kavehs87/nuc-fan-controller/fan-switch-booster/docs/pcb-render-bottom.png

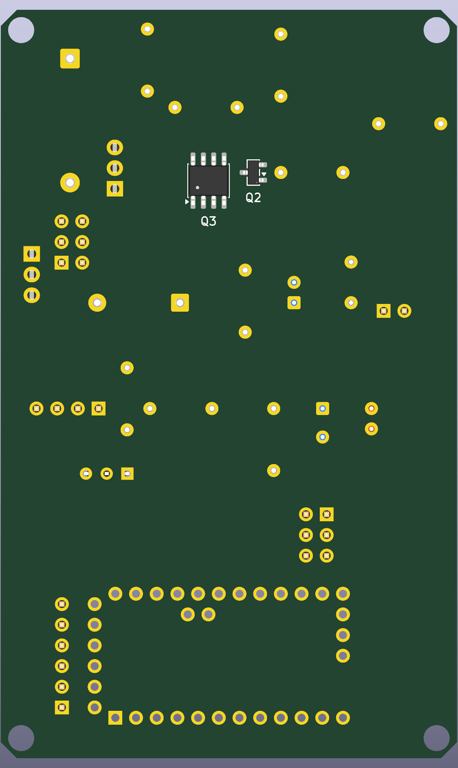
fan-switch-booster/docs/pcb-render-bottom.png
