kavehs87/nuc-fan-controller/fan-switch-booster/docs/pcb-render-smd-copper.png

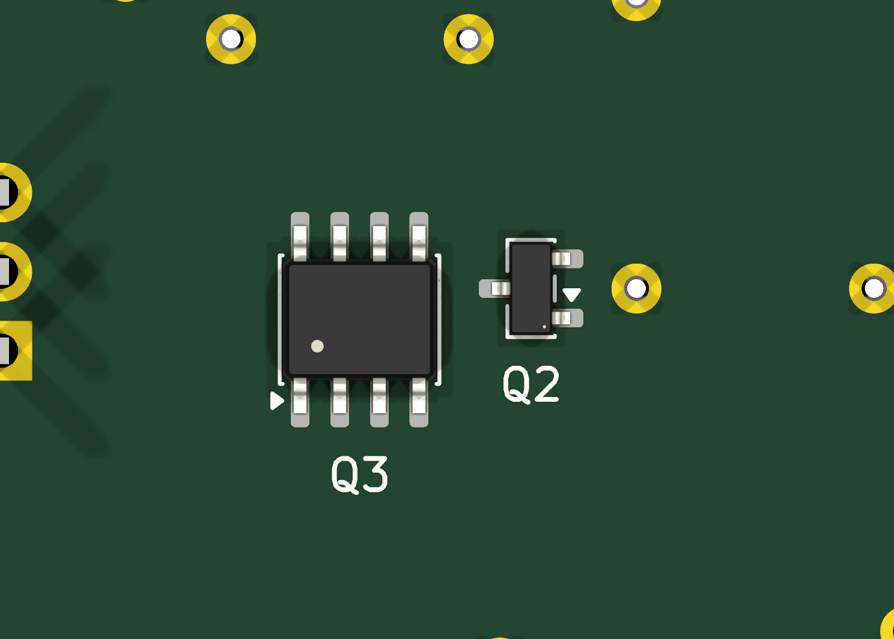
fan-switch-booster/docs/pcb-render-smd-copper.png
