kavehs87/nuc-fan-controller/fan-switch-booster/docs/pcb-render-top.png

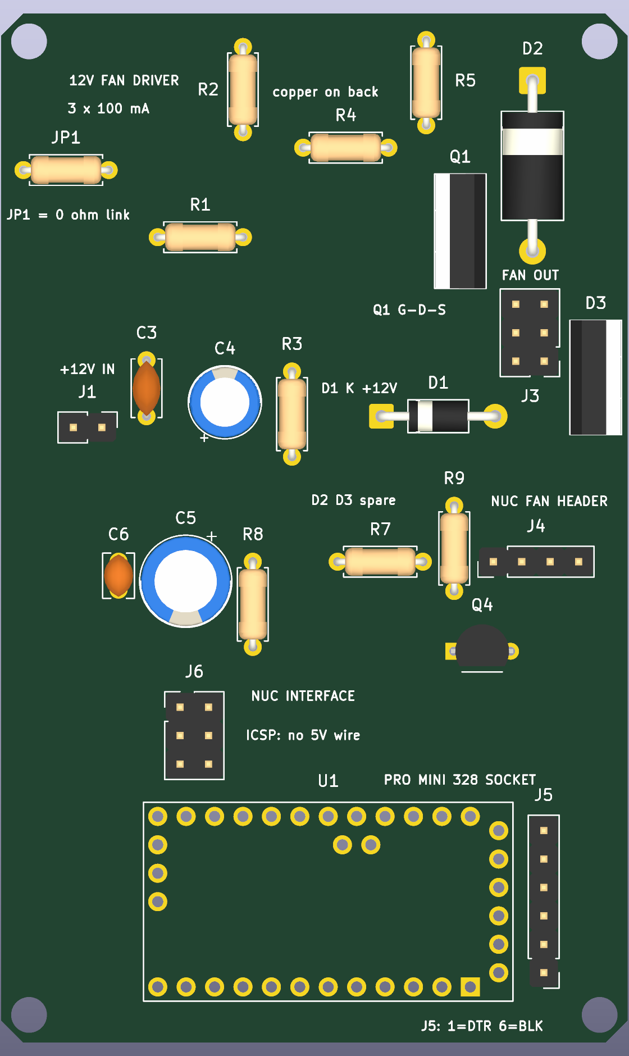
fan-switch-booster/docs/pcb-render-top.png
