kavehs87/nuc-fan-controller/BUILD.md

# nuc-fan-controller — Mode B (19 V → 12 V fan supply, follows the NUC's PWM, simulates the tach)

> **This build sheet is for a retired board.** The board was never built: the perfboard fan‑switch booster in
> `fan-switch-booster/` is the reference, and the KiCad project, exports and board generator this file
> describes were removed from the tree in October 2026 — they are complete at the tag
> **`nuc-fan-controller-full-2026-10-23`**. What is still live here is the *measurement* half of this file:
> identifying the four header wires with a meter, the divider and top‑of‑swing procedure, the BC547 pin‑order
> check, the log pairing and offsets, and the calibration order. Those apply to any build, including the
> perfboard's.

An 88.9 × 76.2 mm single‑copper‑layer board — small enough to etch at home — that sits between a 6th‑gen
NUC's processor‑fan header and a 12 V fan in a custom enclosure. It does four things:

1. brings **12 V** to the fan from an **off-board XL4016E1 step-down module** that plugs into
   J6 (19 V in on pin 3, its two returns on pins 1–2, 12 V out on pin 4);
2. makes **3.3 V** from that 12 V for a 3.3 V / 8 MHz Arduino Pro Mini;
3. reads the **PWM duty the ITE is asking for** and drives the fan at that duty through a
   12 V low-side switch;
4. reports a **tach rate** that matches what that duty would really produce, so the ITE's
   closed loop closes instead of hunting.

The fan is an ordinary **two-pin 12 V fan**: no PWM input, no tach wire. All the speed
control happens on this board, and all the tach the NUC sees is generated here.

The old Mode A board (fixed‑RPM tach simulator only) was archived in `archive/modeA-2026-10-19/`; that
directory went with the retirement and is at the tag. Nothing on it changed.

---

## Files

| File | What it is |
|---|---|
| ~~`nuc-fan-controller.kicad_*`~~, ~~`exports/`~~, ~~`fab/`~~ | **not in the tree any more.** The project, its schematic/board/etch prints, its BOM and its Gerbers are at the tag `nuc-fan-controller-full-2026-10-23` |
| `firmware/nuc-tach-modeB/nuc-tach-modeB.ino` | the sketch, and where the measured ITE constants live |
| `firmware/nuc-tach-modeA/` | the previous fixed‑RPM sketch, kept for reference |
| `firmware/probe-uno/`, `probe-gain/`, `probe-loop/`, `probe-temp/`, `probe-divider/` | the breadboard sketches the measurements below were made with |
| `bench/analyze-ladder.py`, `bench/analyze-temp.py`, `bench/analyze-cold.py`, `bench/analyze-heat.py` | the analysers, run against `bench/data/` — they take log paths and an offset, not defaults |
| `bench/plot-curve.py` | draws `docs/bench/06-ite-fan-response.svg`, the two‑panel graph of the ITE's demand, from the same logs |
| `bench/data/` | the raw logs behind every number in this file: 1 Hz traces of the divider reading, and of the NUC's temperatures — which pair is which run is the table below |
| `docs/bench/` | the bench photos and the fan-response graph the README shows |
| ~~`logs/`~~ | **not in the tree any more.** The board's ERC and DRC reports, `pour.png`, and the whole generator — `build1l.py`, `getfp.py`, `fp-templates.inc`, `setrules.py`, `pourcheck.py`, `verify.py`, `genwires.py`, `applywires.py`, `export.sh` — are at the same tag. The board is *generated*, not drawn by hand: its parts, bars, holes and router live in `build1l.py`, and `verify.py` was the check KiCad cannot do — whether the pour is one island that reaches every GND pad, and whether every net is one piece of copper matching the schematic pin by pin |

**Which log is which run.** The Uno's logs print one line per second and carry no timestamps; the NUC's
logs are epoch-stamped with `PHASE` markers, so a pair is aligned by the offset the capture scripts were
started with (the Uno opens the port, which resets the board, a known number of seconds before the NUC
starts logging). `analyze-heat.py` takes that offset as an argument.

| Uno log | NUC log | what the run was |
|---|---|---|
| `loop.log` | — | the RPM ladder 800 / 2000 / 4500 with the fan drive pinned at 90 %; no temperature capture |
| `temp.log` | `stress.log` | claim frozen at 1500 RPM, package 55 → 83 → 53 °C, bench fans switched by hand |
| `cold.log` | `coldtemp.log` | claim frozen, bench fans at maximum, package 32–36 °C for twelve minutes |
| `stress2.log` | `stress2-temps.log` | claim frozen, fans at maximum, `stress-ng --cpu 4` for 300 s: package 34 → 73 °C, board only to 55.5 °C |
| `warm.log` | `warm-temps.log` | claim frozen, bench fans off, NUC blower at minimum, board warmed by hand, then `stress-ng --cpu 4` for 240 s: board to 68.5 °C, package pinned at 88 °C |
| `hold.log` | `hold-temps.log` | claim frozen, fans off, a 300 s four-core ramp then **1200 s at a two-core load** so the board sits at 68.5–69 °C for sixteen flat minutes — the time-at-temperature test. Its `baseline` loop was left out of the capture script, so the log starts mid-ramp at 41 °C |
| `nucmon-idle.log` | — | the NUC's own sensors at idle, for the record |

*The next three paragraphs are the retired board's CAD record, as of 2026‑10‑20. They are kept because the
findings in them are transferable; the commands cannot be re‑run from this tree.*

**ERC: 0 violations.** **DRC: 0 errors** after `kicad-cli pcb drc nuc-fan-controller.kicad_pcb
--refill-zones --save-board` (2026-10-20), with 26 `lib_footprint_mismatch` warnings and 1
`unconnected_items` warning, both explained under *Board*: every footprint on this board is a modified
copy of a library footprint, and the one thing joining the two halves of `FAN_PWM` is the 0 Ω bridge R11,
which a board-only ratsnest cannot know is a part.

`logs/verify.py`, which does not care what KiCad thinks, reports: every net is one piece of copper
(`FAN_PWM`'s two pieces joined by R11), the pour is one island of 5 009 mm² and every GND pad lies inside
it, no copper of two nets touches, and the board matches the schematic netlist pin by pin on all 30
components.  The schematic's own no-connect is J2 pin 4, the NUC header's fan-supply wire, which this
board deliberately does not connect.

The schematic is drawn with **wires, not net labels**: every pin reaches its neighbour
through a drawn wire, and the rails are `power:+12V / +3V3 / GND` symbols sitting on
the pins. Every signal net carries a name tag (`19V`, `FAN_SW`, `BASE`,
`FAN_GATE`, `GATE`, `TACH_BASE`, `NUC_TACH`, `NUC_PWM`, `PWM_DIV`, `PWM_IN`, `TACH_OUT`, `FAN_PWM`) so
the print, the netlist, the board and the Gerber netlist all use the same readable names.
Delete a tag and KiCad renames that net to `Net-(…)` everywhere downstream.

---

## The circuit, in five blocks

*The circuit as the retired board drew it, in the designators that board used. The built version of the same
idea — the gate booster, its nets and its measured behaviour — is `fan-switch-booster/README.md`.*

```
A. 19 V in, the module, 12 V out            B. 12 V → 3.3 V, for the Pro Mini only
   J1 19V IN ─ 19V ─ J6 pin 3                 +12V ─ U3 AMS1117-3.3 ─ +3V3
   J1 pin 2 ─ GND ─ J6 pin 2                   C7 10µ + C8 100n on 3V3
   J6 pin 1 ─ GND                              C9 100p sits on NUC_TACH, TP1 is its test point
   J6 pin 4 ─ +12V ─ C3 470 µ/25V ─ C4 100n ─ GND
   J6 is the module's socket: 19 V in on 3, its two returns on 1 and 2,
   12 V out on 4. The XL4016E1 itself is not on this board — it is bolted to
   the enclosure and connected to J6 with a four-wire harness.
   There is no 5 V rail anywhere on this board: a drive's 5 V must never come from here.

C. NUC interface (signals only)             D. 12 V fan speed drive
   J2  NUC fan header                        FAN_PWM (from D11) ─ R6 1k ─ BASE ─ R7 10k ─ GND
     1 GND                                          BASE ─ Q2 BC547B base;  Q2 emitter → GND
     2 NUC_TACH  ─ C9 100p ─ GND                    Q2 collector ─ FAN_GATE ─ R8 1k ─ +12V
     3 NUC_PWM   ─ R3 4.7k                          FAN_GATE ─ R9 120 Ω ─ GATE ─ Q3 gate
                                                   GATE ─ R10 10k ─ GND
     4  (no connect: the header's fan supply)       Q3 IRFZ44N:  gate GATE, drain FAN_SW, source GND
   NUC_TACH ─ Q1 BC547B collector                   FAN_SW ─ D2 1N5819 ─ +12V   (freewheel)
   Q1 base ─ TACH_BASE ─ R2 1k ─ D9 (OC1A)          FAN_SW ─ J7 pin 2 ─ J3 pin 2 ─ J4 pin 2
   Q1 emitter ─ GND                                 FAN_SW ─ C12 100n ─ GND   (snubber at the fan end)
   NUC_PWM ─ R3 4.7k ─ R4 2.2k ─ PWM_IN ─ C10 1µ    +12V ─ J7 pin 1 ─ J3 pin 1 ─ J4 pin 1
                        PWM_IN ─ R5 10k ─ GND
                        PWM_IN ─ C11 100n ─ GND     J7 / J3 / J4 are the three 2-pin 12 V fan connectors
                        PWM_IN ─ A0
E. Pro Mini header J5: 1 GND, 2 TACH_OUT (D9), 3 FAN_PWM (D11), 4 PWM_IN (A0), 5 +3V3
```

**Q1 is open-collector.** It only ever pulls `NUC_TACH` low; the pull-up that makes the
high side is inside the NUC. That is the whole point — a push-pull drive from a 3.3 V pin
would hold the tach line ~1.7 V under whatever rail the ITE pulls it to, and would push
that current into the AVR. Q1 cannot do either, and its Vceo (45 V) is indifferent to
which rail the ITE chose.

**Q2 exists because IRFZ44N is not a logic-level FET.** Its Vgs(th) is 2–4 V, so 3.3 V from
a pin is not enough to turn it on. Q2 is driven by the AVR, and R8 1 kΩ pulls Q3's gate to
+12 V whenever Q2 is off. Q2 inverts once; the sketch inverts once more, so the fan ends up
with the duty the ITE asked for. R7 (10 kΩ base pull-down) and R10 (10 kΩ gate pull-down)
hold the two transistors off during the ~1.2 s the Pro Mini's bootloader leaves its pins
floating, which otherwise leaves Q3's gate at the mercy of a 12 V pull-up through 1 kΩ.

**D2 is not optional.** A fan is a motor winding. Every time Q3 turns off, that winding
kicks `FAN_SW` above the 12 V rail; D2 (1N5819, 40 V, 3 A) clamps it back into the rail it
came from. Without it the edge rings into the 12 V rail, and no buck — this one switches at
about 180 kHz and regulates through an output capacitor, not through the fan's commutation —
is fast enough to clean that up.

**C12 100 n sits on FAN_SW at the fan end.** `FAN_SW` is the node the commutating fan windings and D2's
recovery both live on, so it is the noisiest place on the board. 100 n there is a small snubber: against the
~120 Ω a 12 V fan presents at full speed it is a 12 µs time constant, which is short enough not to blunt the
32 µs pulses of the 31.25 kHz drive and long enough to take the edge off the switching spike.

**C9 is 100 pF, not 100 nF.** At 40 Hz with a 1–10 kΩ pull-up, 100 nF gives a 0.1–1 ms time
constant against a 12.5 ms half-period — harmless — but 100 nF on a tach line invites
ringing and crosstalk from a 31.25 kHz fan drive sitting 30 mm away. 100 pF kills RF and
leaves the edges alone.

---

## BOM, and where the parts came from

*This is the retired board's BOM. The reference build — the perfboard — has its own parts sheet now:
`docs/parts-collection.md` §1, and the schematic‑side list is `fan-switch-booster/README.md`,
*Parts — all from my cabinets*.*

All through-hole except one SMD part — U3, a TO-252 — which is hand-solderable without a stencil.  All
already in the cabinet.  `docs/parts-collection.md` and its `.html` twin carry the same list as a
walk-the-cabinet checklist, with quantities including spares and the measurements each part has to give up
before its footprint can be fixed.

| Ref | Value | Footprint | Cabinet |
|---|---|---|---|
| C3 | 470 µF 25 V | `Capacitor_THT:CP_Radial_D8.0mm_P3.50mm` — the board puts its pads 5.08 mm apart; **the cabinet's 8×20 can has to give up its lead pitch** | L1 C1 (6) |
| C4, C8, C11, C12 | 100 nF | `Capacitor_THT:C_Disc_D6.0mm_W2.5mm_P5.00mm` — the library draws 5.00 mm pitch, the board uses 5.08 so the pads sit on the grid | L1 C9 (30) |
| C7 | 10 µF | `Capacitor_THT:CP_Radial_D6.3mm_P2.50mm` | L1 D3 (4), spare pool L1 C1 (19) |
| C9 | 100 pF | `Capacitor_THT:C_Disc_D3.8mm_W2.6mm_P2.50mm` | L1 C9 (8) |
| C10 | 1 µF | `Capacitor_THT:CP_Radial_D6.3mm_P2.50mm` | L1 E7 (8) |
| U3 | AMS1117-3.3 | `Package_TO_SOT_SMD:TO-252-3_TabPin2` — the cabinet's TO-252 part; **the SOT-223 in the same drawer will not fit these pads** | L1 B1 (19) |
| R3 | 4.7 kΩ | `Resistor_THT:R_Axial_DIN0204_L3.6mm_D1.6mm_P5.08mm_Horizontal` | R1 B2 |
| R4 | 2.2 kΩ | same | R1 A2 |
| R5, R7, R10 | 10 kΩ | same | R1 B2 |
| R2, R6, R8 | 1 kΩ | same | R1 A2 |
| R9 | 120 Ω | same | R1 B1 |
| **R11** | **0 Ω — board only, not in the schematic** | same DIN0204 footprint | the bridge that carries `FAN_PWM` over the divider row: a 0 Ω, a scraped-off component lead, or a staple of bare wire |
| Q1, Q2 | BC547B | `Package_TO_SOT_THT:TO-92_Inline_Wide` | R1 D3 (20) — **meter them first, see "Which way round a BC547 goes"** |
| Q3 | IRFZ44N | `Package_TO_SOT_THT:TO-220-3_Vertical` | R1 B4 (12) |
| D2 | 1N5819 | `Diode_THT:D_DO-41_SOD81_P10.16mm_Horizontal` — kept at the library's 10.16 mm pitch, so the silk outline matches the part | L1 E1 (30) |
| J1, J3, J4, J7 | 19 V IN · FAN 1 · FAN 2 · FAN 3 | `Connector_PinHeader_2.54mm:PinHeader_1x02_P2.54mm_Vertical` — **male** strips | L1 E9 (7) — snap from a 5-pin strip |
| J6 | BUCK MODULE — 1, 2 GND · 3 19 V · 4 12 V | `Connector_PinHeader_2.54mm:PinHeader_1x04_P2.54mm_Vertical` — male | L1 E9 — snap a 5-pin strip to 4 |
| J5 | Pro Mini | `Connector_PinHeader_2.54mm:PinHeader_1x05_P2.54mm_Vertical` — male | L1 E9 (7) — a 5-pin strip, as it comes |
| J2 | NUC fan header | `Connector:FanPinHeader_1x04_P2.54mm_Vertical` — the shrouded 4-pin header the NUC's fan plug mates with.  The board's copy has its retention-peg hole left undrilled: the peg lands on the `NUC_PWM` lane | L1 E9 — snap a 5-pin strip to 4, shrouded if the cabinet has one |
| TP1 | TACH test point | `TestPoint:TestPoint_Pad_D1.5mm` | no part: a bare pad |
| MK1–4 | M3 mounting holes | `MountingHole:MountingHole_3.2mm_M3` | no part: a 3.2 mm hole |
| — | Arduino Pro Mini **3.3 V / 8 MHz** | 5-pin header into J5 | L1 C5 (1) |
| — | **XL4016E1 step-down module**, 19 V in → 12 V out | off-board, bolted to the enclosure, four wires into J6 | L1 A10 (1) |

The BOM csv KiCad writes has 30 lines, not 35: R11, the four mounting holes, the module and the Pro Mini
are not schematic components, so they are correctly absent from it.  They are on this table because the
table is what gets built.

**Why the buck is a module now.** This board used to build its converter out of parts — LM2596T-ADJ,
a 100 µH 6 A toroid, a 1N5822 catch diode, and a 10 kΩ trimmer in the feedback divider with R1 1 kΩ
under it. That design is in git at `10bc262` and every part of it is still in the cabinet (LM2596T and
LM2576HVT in L1 E7, 100 µH toroids in L1 A7, 1N5822 in L1 E1, 10 kΩ multi-turn trimmers in R1 A3). What changed is
that the cabinet also holds a finished step-down module, and at 12 V / 0.3 A a finished module is the
better answer: the **XL4016E1 module in L1 A10** carries the XL4016E1 controller and a 20S100 Schottky
catch diode, each on its own heatsink, with its input and output electrolytics and two multi-turn trimmers
— CV for the output voltage, CC for a constant-current limit — so RV1, R1, C1, C2, U1, D1 and L1 all left
the board and one 4-pin header took their place.

The numbers that make it safe come from the module's own catalogue record, cross-checked against the bare
XL4016E1 data sheet (LCSC **C55881**, TO-220-5):

* **5–40 V in (≤32 V for continuous use), 1.2–36 V out, 8 A continuous and 12 A with extra cooling, about
  180 kHz, 95–96 % efficient, ~50 mV output ripple.** 19 V in and 12 V out sit in the middle of all of it,
  and the output must be below the input — which is this design, and the reason a buck-boost is not needed.
* **Hugely derated at this load.** Three fans at full speed are 0.3 A out of an 8 A part (measured, see
  *Power budget*), so its dual heatsinks sit barely warm and its short-circuit, overload and
  over-temperature protections never have to do anything.
  Its record also lists input reverse-polarity protection, which is a courtesy this board does not have:
  J1 pin 1 is +19 V and C3 is a 25 V part.
* **It stays in continuous conduction where the fans actually work**, which is what makes a big buck
  unpleasant at a small current: inductor ripple is `Vout × (1 − Vout/Vin) / (L·f)` ≈ 12 × 0.368 /
  (150 µH × 180 kHz) ≈ **0.16 A** peak-to-peak, so the boundary is about 0.08 A and 0.3 A clears it by
  almost 4×. Near the ITE's idle demand the rail current drops below it — see *Power budget* for why C3
  and `FAN_DUTY_MIN` are the answer to that.
* **Its ripple does not reach the analogue side.** 50 mV at 180 kHz on the 12 V rail goes through two
  AMS1117 LDOs before it can touch 5 V or 3.3 V, and the `PWM_IN` divider's time constant is milliseconds
  against a 5.6 µs switching period — attenuation of about 5 000×, so those 50 mV arrive at A0 as 10 µV.
  The divider's own ripple budget, from the ITE's 23 kHz signal, is 2.2 counts (see *Known limits*); the
  buck is nowhere near it.

The module is about **61 × 41 × 27 mm** with its heatsinks, which is the whole reason it is off the board:
that is a third of the board's area and 27 mm of height, and its heatsinks want air moved across them
rather than a lid sitting on top. The other candidate in the cabinet was the **LTC3780 buck-boost module**
(L1 A5: 5–32 V in, 1–30 V out, 10 A, 80 W, 78 × 47 mm, replaceable fuse); it is the bigger board and it
buys nothing here, because this supply's input is always above its output. The DC modules that are *not*
candidates are worth naming so the search does not have to be repeated: the "Switching Power Supply Module
6th Gen 12 V 450 mA" (L1 B7) takes 85–265 V AC, and the IP2721 PD trigger (L1 A5) and the 100 W USB-PD
output module (L1 E5) need a USB-C source that negotiates 12 V.

**Why 120 Ω for R9** rather than the usual 10–47 Ω gate resistor: there is no 100 Ω or 47 Ω
value in the cabinet in the size needed. It is not the resistor that limits turn-on, though —
with Q2 off the gate is fed through R8 1 kΩ + R9 120 Ω = 1.12 k, so turn-on current is
12 / 1.12k = **10.7 mA**, and R10 10 kΩ pulls the gate down to 12 × 10 / 11.12 = **10.7 V**,
above the 10 V at which IRFZ44N's Rds(on) is specified. R9's real job is the fast half: on
turn-off the gate dumps through 120 Ω alone into Q2's saturated collector (≈ 89 mA), so the
falling edge is under 1 µs. Turn-on is the slow half — 1.7 µs to charge Ciss 1.5 nF, then
≈ 7.5 µs of Miller plateau at 6.1 mA out of the 32 µs period, which costs about 0.3 W in the
FET at a 0.2 A fan and leaves the fan's true duty roughly 7 µs short of the commanded one.
Both are why the RPM mapping is calibrated at the bench rather than derived from arithmetic.
Dropping R8 to 470 Ω (two 1 kΩ in parallel) would cut the plateau to about 3 µs if the FET
ever runs warm; it raises Q2's collector current to 21 mA, which 2.6 mA of base drive still
saturates.

**Two SMD parts.** The SOT-223 regulators are the only ones. They are hand-solderable with
a fine tip and a little flux (drag the tip across the three pads with solder on it), and
their tab pad is the VOUT pad on this footprint, which is the one that wants the most heat.
If you would rather not solder SMD: an AMS1117 in TO-263 will not drop into this footprint,
so keep the SOT-223.

---

## Power budget, and what the board actually carries

*Retired board's budget — the numbers are still the right ones for any 12 V build of this idea.*

| Rail | What hangs off it | Worst case |
|---|---|---|
| 19 V in | J1 → J6 → the module's input | 0.4 A at 12 V / 0.3 A out, ~90 % efficiency |
| +12 V | J6 pin 4, C3/C4, U3, R8, D2, J7, J3, J4 | **0.3 A, measured** — three 12 V fans at full speed, 300 mA together |
| +3V3 | Pro Mini, C7/C8, the divider's load side | ~25 mA |
| FAN_SW | Q3's drain, J7/J3/J4 pin 2, D2, C12 | 0.3 A pulsed |

**The fan load is measured, not assumed: three 12 V fans at full speed draw 300 mA together at 12 V** —
100 mA each, 3.6 W. The board has one 2-pin connector per fan (J7, J3, J4), so each carries 0.1 A through a
header rated at 3 A. That is 0.3 A out of an 8 A module — under 4 % of its rating, heatsinks
cold — and the IRFZ44N dissipates I²·Rds(on) = 0.3² × 0.045 ≈ **0.004 W**, with a 55 V Vds and a 3 A
catch diode behind a fan bank that never asks for either. On this board the current is carried by drawn
bars 1.80 mm wide — 0.3 A through 1.8 mm of 35 µm copper is a couple of degrees above ambient — and the
return goes back through the ground pour, 5 009 mm² of it, rather than through a trace.

One thing the small load does bring. The module's inductor ripple is ≈0.16 A peak-to-peak, which puts its
continuous-conduction boundary near **0.08 A**, and fan current scales with speed: at the bottom of the
duty range three fans draw well under that. So near the ITE's idle demand the module can slip into
discontinuous conduction — not harmful, but it is where a buck becomes audible and its ripple gets worse.
Two things already on the board answer it: C3 470 µF sitting on the rail, and `FAN_DUTY_MIN`, which keeps
the fan idling at its stall duty instead of at a duty so low the converter starts ringing.

U3 drops 12 V to 3.3 V at ~25 mA: 8.7 V × 0.025 A = **0.22 W**, trivial for a TO-252 with its tab soldered
to a copper bar.  There is no 5 V rail on this board; the Pro Mini and the sense divider are all it powers.
Do not hang anything bigger off 3.3 V — U3 is a 1 A part and its junction rises fast in a closed enclosure.

---

## Before wiring anything: identify the four wires

Intel's *NUC6i5SYB / NUC6i3SYB Thermal Design Power Specification* (H92311-008) publishes no
signal table for the processor-fan header. It publishes only the current limit — **Table 23:
processor fan header, 0.25 A max** — and §2.2 advises against powering external devices from
internal headers at all. So the four wires get identified with a meter, not from a datasheet:

1. **GND** — continuity to the NUC's USB shell or bare chassis, NUC off. → `J2.1`
2. **TACH** — sits high and *moves*: a frequency counter or scope on it while the stock fan
   spins reads 20–350 Hz. It is the only one of the four that pulses. → `J2.2`
3. **PWM** — 21–28 kHz (25 kHz nominal), so a multimeter shows a steady 2–3 V average that
   changes when the fan audibly speeds up. → `J2.3`
4. **Whatever is left** — on this generation that is the header's fan **supply** wire (5 V on
   a stock BSB05505HP fan). → **leave it unconnected.** It goes on J2's fourth pin only so
   you can see it, and the schematic puts a no-connect flag on that pin.

Mark the wires before cutting anything. Cutting first and identifying later is how this gets
reversed, and reversing the supply wire into the tach input is how the ITE gets hurt.

**This board takes no power from the NUC.** Everything it burns comes from the 19 V tap. What
crosses to the NUC side is three signal wires and a shared ground.

---

## Four rules that keep the NUC alive

1. **The stock fan is 5 V, not 12 V.** A 6th-gen NUC ships a BSB05505HP (5 V, 0.4–0.5 A).
   Never splice a 12 V fan's tach or PWM wires into J2: a 12 V fan pulls its tach and PWM
   lines up to its own 12 V rail internally, and 12 V on the ITE's 3–5 V input is how the
   controller dies.
2. **The external 12 V negative must be tied to NUC ground**, through J2.1. Without a common
   reference none of the three signal wires mean anything, and the tach line floats.
3. **Nothing 5 V may touch a 3.3 V pin.** The ATmega328P's absolute maximum on any pin is
   VCC + 0.5 V. This board never puts 5 V on an AVR pin — the Pro Mini is fed 3.3 V on VCC
   (its **RAW** pin is unused), and the PWM line is divided down to 2.96 V before it reaches
   A0. Flash it with a **3.3 V** FTDI.
4. **Measure the PWM wire's amplitude before trusting the divider.** R3 4.7 k + R4 2.2 k in
   series against R5 10 k puts 10 / 16.9 = 0.59 of the line on A0, i.e. **2.96 V for a 5 V
   swing**. If your header's PWM actually swings to 12 V, that node would hit 7.1 V and
   exceed the chip: change **R5 from 10 kΩ to 2.2 kΩ** (both are in the cabinet), which
   brings the node to 2.9 V for a 12 V swing.

The tach line sinks 1–5 mA into the ITE's pull-up and the PWM divider draws 5 V / 16.9 kΩ
≈ 0.3 mA: about 5 mA total from a header rated at 250 mA, and none of it is power.

---

## Board

> **Retired record — the commands in this section cannot run any more.** The board file, its generator and
> its exports are at the tag `nuc-fan-controller-full-2026-10-23`. What is worth keeping from this section is
> the *reasoning*: the rules a home-etched single-layer board actually needs, why every footprint here is a
> deliberately modified copy, and why the ratsnest complains about a net that a 0 Ω resistor joins.

**88.90 × 76.20 mm, one copper layer, made at home.** The single layer is F.Cu, and F.Cu is the
component side: pads, traces, the pour and every part are on the same side, so the copper you etch is
the copper you solder to and nothing about the board is mirrored.  (The two-layer board this replaced was
124.0 × 85.0 mm; it is in git, and `exports/` no longer carries a bottom plot because there is no bottom.)

- Four M3 mounting holes, 5.08 mm in from the left and right edges, 5.08 mm below the top edge and
  7.62 mm above the bottom edge.  Their positions are provisional: they move when the enclosure is measured.
- **GND is a pour over the whole board** — 5 009 mm² filled, one island — with `connect_pads yes`, so the
  fill bonds solidly to every GND pad.  Thermal-relief spokes would be four thin necks per pad to
  over-etch and they buy nothing at these currents.  `logs/verify.py` checks the thing DRC cannot: that
  every GND pad lies inside *that one island*, not in a pocket the pour never reaches.
- The rules, each one a number a home process can hold:

  | rule | value | why |
  |---|---|---|
  | clearance, every net | 0.70 mm | the isolating scratch a toner-transfer etch can be trusted to leave |
  | minimum track | 0.70 mm | the same scratch, on the other side of the gap |
  | drawn rails (`+12V`, `FAN_SW`, `19V`) | 1.80 mm | 0.3 A through 1.8 mm of 35 µm copper is a few °C, and a wide rail survives a sloppy etch |
  | copper to board edge | 0.50 mm | the outline is sawn or cut, and copper chips at the cut |
  | minimum drill | 0.90 mm | below that a hand drill wanders; the drill file holds 0.90 / 1.00 / 1.02 / 1.10 / 3.20 mm |
  | maximum pad | 1.80 mm | on a 2.54 mm grid two 1.80 mm pads still leave 0.74 mm, which is the clearance rule |
  | pour minimum thickness | 0.80 mm | thinner slivers of pour etch clean off |
  | annular ring | 0.25 mm | the smallest ring a hand-drilled hole leaves |

- **One crossing, bridged by a 0 Ω resistor.** The Pro Mini's A0 (`PWM_IN`) and D11 (`FAN_PWM`) sit side by
  side on J5, and where they have to go is on opposite sides of the divider's row: `PWM_IN` is fed from the
  row's own bar, `FAN_PWM` has to climb from the header to the fan drive above it.  On one layer there is
  nothing to route around — the divider row spans the band and the `FAN_PWM` column runs from the header up
  through it.  So **R11**, a 0 Ω resistor (a scraped-off lead, or a staple of bare wire, does the same job),
  carries `FAN_PWM` over the divider row at (53.34, 48.25).  R11 is a board part only: the schematic has no
  such component, and the BOM lists it as one.
- Everything else is a crossing-free route.  The nets that would fight each other are **drawn as bars**
  rather than handed to the router — `+12V`, `FAN_SW`, `19V`, `+3V3`, `FAN_PWM`, `NUC_TACH`, `NUC_PWM`,
  `TACH_OUT`, `TACH_BASE`, `PWM_IN` — because a long trace left to an A* wanders to the board perimeter and
  walls the ground pour off; the router finishes only the short legs between them.
- Flow: 19 V arrives at J1 top-right and goes to the module through J6; the module's 12 V comes back on J6
  pin 4 and runs left along the **+12 V rail at y = 17.78**, with a riser up the right edge at x = 81.28 to
  the 3.3 V regulator U3; the **fan rail (FAN_SW) at y = 20.32** runs under the three fan connectors, which
  straddle the two rails with no routing at all, and lifts at x = 66.04 to Q3's drain and at x = 73.66 to
  D2's cathode; the fan drive (Q2, R6–R10, Q3) is the band at y = 25–43; the tach front end and the PWM
  divider are the band at y = 50–64; the NUC's fan header J2 sits bottom-left and the Pro Mini's header J5
  runs along the bottom edge, with the 3.3 V rail 5.08 mm above it so a trace can still come down onto
  every pin but the one its own stub lands on.
- How it is made, and the loop that keeps it honest:

  The loop that kept it honest — none of these files is in the tree now, so run it from a worktree of the
  tag if the board is ever rebuilt:

  ```
  python3 logs/build1l.py            # writes the board from PARTS / BARS / HOLES in the script
  kicad-cli pcb drc nuc-fan-controller.kicad_pcb --refill-zones --save-board
  python3 logs/pourcheck.py          # models KiCad's fill, writes logs/pour.png
  python3 logs/verify.py             # nets, pour island, shorts, netlist parity
  ```

  `logs/fp-templates.inc` is the footprint artwork cloned out of the KiCad 10 libraries by `logs/getfp.py`
  (regenerate it, never hand-edit it); `logs/setrules.py` writes the rules above into the project file.
- **DRC after that loop: 0 errors.**  What is left is 26 `lib_footprint_mismatch` warnings and 1
  `unconnected_items` warning, and both are the board telling the truth:
  * every footprint here is a *modified* copy — drills enlarged to ≥ 0.90 mm, pads capped at 1.80 mm,
    several pitches re-spaced onto the 2.54 mm grid — so KiCad is right that they differ from the library
    copies, which is exactly the point of a home-etch board;
  * the ratsnest wants copper joining the two halves of `FAN_PWM`, and the thing joining them is R11, which
    a board-only ratsnest cannot know is a component.  It is downgraded to a warning in the project file
    (`logs/setrules.py`) because `logs/verify.py` checks the real question: every net is one piece of
    copper, with R11 named as the join.
- Etching: `exports/nuc-fan-controller_etch_copper.pdf` and `.svg` plot F.Cu and Edge.Cuts at 1:1 — the SVG
  is 88.90 × 76.20 mm exactly.  Print with scaling off, iron the toner onto copper-clad, etch, drill at the
  five sizes in `exports/fab/nuc-fan-controller.drl`, then cut to the outline.  `..._etch_negative.pdf` is
  the same plot inverted, for a process that removes what is black.
- `exports/fab/` is 4 Gerbers (F.Cu, F.Silkscreen, F.Mask, Edge.Cuts) plus the drill file and `job.gbrjob`.
- Two things this layout waits on, both of which are measurements rather than decisions: **J5** is drawn as
  one 1×05 header, but a real Pro Mini's D9/D11 are on one row and A0/VCC/GND on the other, so J5 may become
  two headers; and the outline only becomes final when the enclosure's standoff positions are known.

The layout note that replaced the old switch-node one: **there is no switching node on this board any more.**
19 V arrives at J1, runs to J6 pin 3, and the module's 12 V comes back on J6 pin 4 onto the rail.  The
module's own output electrolytic does the bulk filtering at the module; C3 (470 µF) and C4 are the board's
local decoupling where the rail lands, 30 mm along the rail from J6.  The module's return goes back through J6's pins 1–2, which are 2.54 mm from its 19 V and 12 V pins,
so the module's return current enters the pour at the same point the sense divider's ground does rather than
somewhere down the rail.

---

## Which way round a BC547 goes

`BC547` is not one pinout. **NXP/Philips — the order most of what arrives in an unbranded 20-piece bag
uses — is 1 emitter · 2 base · 3 collector.** onsemi/Fairchild/MCC publish the same part number as
1 collector · 2 base · 3 emitter. The base is the middle pin either way, so the whole question is whether
pin 1 is the emitter or the collector, and nothing on the package says which.

**This board is drawn and routed for E-B-C.** Q1 and Q2 carry the symbol `Q_NPN_EBC` in the schematic —
KiCad's own `Transistor_BJT:BC547` is the onsemi order, which is why the symbol was replaced rather than
relabelled. On the board Q1's pad 1 is the emitter in the GND pour and pad 3 carries `NUC_TACH`; Q2's pad 1
is the emitter in the GND pour and pad 3 carries `FAN_GATE`. Pad 1 is the square pad, and the silkscreen
between the two transistors reads `Q1 Q2 1=E 2=B 3=C`.

Meter them before fitting. A diode test only proves the middle pin is the base, which is true of both orders.
What separates them is gain: read hFE in a transistor meter, then swap the outer two pins and read again. A
BC547B gives **200–450 forward and single digits reversed** (reverse-active gain is 0.5–5), so the orientation
that reads a real hFE is the orientation this board expects. If the parts read the other way they are C-B-E
parts: fit BC548s in the right order, or seat them with the flat face away from the printed outline so the
collector lands in the square pad — electrically fine, but it leaves the pin-1 marker pointing at the collector
for whoever builds from this print next.

Fitted the wrong way round both transistors run reverse-active: Q1 barely pulls the tach line low on the
2.6 mA R2 gives a device with a reverse gain of ~2, and Q2's emitter-base junction — rated 6 V — sits behind
R8 against the 12 V rail.

---

## Set the module to 12.0 V before it is connected to anything

1. Fit J1, J6, C3 and C4. Fit **nothing** on the 5 V / 3.3 V side yet.
2. Set the module up on the bench: 19 V into its IN terminals, a meter on its OUT terminals, the
   supply current-limited. Turn its voltage trimmer until it reads **12.0 V** on the meter. These
   modules ship preset anywhere in their 1.2–36 V range, so a module that has never been set is a
   module that may hand the AMS1117 chain anything.
3. Make sure its **current limit is released**. These boards carry a second trimmer (CC) that makes
   the module a constant-current supply, and a fan winding draws inrush. Load the module with the
   fans actually starting and watch the meter: if the 12 V rail sags while a fan is coming up, the
   limit is engaged — turn that trimmer the other way until the rail holds above ~11 V through the
   start. A current-limited module feeding a stalled fan is a fan that never reaches the duty the
   ITE asked for, and the sketch will happily keep claiming it did.
4. Then fit U3 (the one SMD part: tin one pad, seat it, solder the tab, then the rest) and check 3.3 V.
   Then meter Q1/Q2 against "Which way round a BC547 goes" and fit Q1/Q2/Q3.
5. Wire the module to the board with four short wires, twisted in pairs: module IN+ and IN− onto
   **J6 pins 3 and 2**, module OUT+ and OUT− onto **J6 pins 4 and 1**. The board's silkscreen beside
   J6 reads `module: 1 2 GND 3 19V 4 12V`, and J1 pin 1 is the +19 V that feeds J6 pin 3.

Check the 19 V tap's polarity before plugging in. The module's own record claims input reverse‑polarity
protection, but nothing on this board has any: the 19 V runs from J1 to J6 as a bare track and C3 is a
25 V part, so the lead that lands on J1 pin 1 has to be the + of the tap.

**Mounting.** The module is about 61 × 41 × 27 mm with heatsinks on both faces. Bolt it to the
enclosure wall where the fan's air passes it. Its 8 A rating is a heatsink rating, and at 0.3 A it is
comfortable even in a closed box, but a heatsink under a lid is a heatsink that runs 40 °C warmer
than it has to, and the module is the one part in this design that is allowed to get warm.

---

## Firmware

`firmware/nuc-tach-modeB/nuc-tach-modeB.ino`. Board → *Arduino Pro or Pro Mini*,
Processor → **ATmega328 (3.3V, 8MHz)**, programmer → the FTDI on the Pro Mini's own 6-pin
header, board powered from the FTDI and **not** from the 19 V tap while flashing.

Three hardware timers do all the work:

| Pin | Timer | What it makes |
|---|---|---|
| D9 (OC1A) | Timer1, CTC on ICR1, prescaler /8 | the tach square wave, `ICR1 + 1 = 15 × (F_CPU/8) / RPM` → 15 000 000 / RPM at 8 MHz |
| D11 (OC2A) | Timer2, fast PWM, TOP = 255, prescaler /1 | 8 MHz / 256 = **31.25 kHz** fan drive |
| A0 | ADC, 16-sample mean | the ITE's duty, through the divider and C10/C11 |

The ITE counts 2 tach pulses per revolution, so `RPM = 30 × f_tach`: 40 Hz reads 1200 RPM.
Timer2's pin is high for OCR2A counts out of 256; Q2 inverts that once and the sketch inverts
it again (`OCR2A = (100 − duty) × 256 / 100`), so the fan gets the duty the ITE asked for.

The constants at the top of the file are the calibration surface:

| Constant | Default | What it is |
|---|---|---|
| `FAN_RPM_FULL` | 3000 | your fan's RPM at 100 % duty |
| `FAN_RPM_MIN` | 900 | its RPM at `FAN_DUTY_MIN` |
| `FAN_DUTY_MIN` | 20 % | duty below which this fan stalls |
| `TACH_RPM_FLOOR` | 700 | stay above the ITE's stall detect (~1–2 s without pulses = fan error) |
| `TACH_RPM_CEIL` | 10500 | the ITE stops counting above ~11 000 RPM |
| `ADC_AT_100PCT` | 918 | 2.96 V ÷ 3.3 V × 1023 — the two-point calibration's top point, for the divider the schematic carries |
| `ITE_READ_GAIN` | 1.0 | what the BIOS reads ÷ what the timer emits. Measured Uno → this NUC: **1188 shown for a 40.000 Hz claim** (0.9900). Measure it on the finished board |
| `DEMAND_TAU_S` | 15 s | the pole the ITE's demand is read through. Measured, not taste: see *The demand is stepped, not analog* and the response times under *The ITE's PWM demand answers the board's temperature* |
| `DEMAND_DEADBAND` | 1.5 duty points | below this the fan is left alone, so the ITE's own cycling does not pump it |

The demand filter is slow on purpose. Measured at a constant 33 °C package, this ITE dwells at two
duty levels 59 counts apart — 11.5 duty points — and ramps between them in 1–3 s, moving by more than 3
counts in 535 of 716 seconds; with the board hot it dwells at 320 and 380 instead, the same 61-count
spacing one rung up. A 300 ms pole hands that whole dance to the fan, which then pumps at
about 0.3 Hz for no thermal reason. tau 15 s with a 1.5 point deadband drops the pump and keeps the
response: the lag at 0.1 °C/s is 0.6 points, inside the deadband, so the fan sits at most 1.5 duty
points behind the ITE's own set point. The reported RPM is slewed by 400 RPM per 100 ms update
(4000 RPM/s), because the ITE integrates the tach over about a second and a step in the reported rate
reads to it as a fan that surged.

It prints one line per update at 9600 baud — `duty_in`, `duty_fan`, `rpm`, `hz`, `adc` — which
is what the calibration below reads.

Expect one boot behaviour: the Pro Mini's bootloader holds the pins quiet for ~1.2 s after
power-on, so the tach line is high and pulseless for the first second of every start, and Q3's
gate is held low by R10 during that window (the fan stays off, which is the safe thing). The
ITE's stall window is 1–2 s. If this NUC's BIOS complains about a fan on boot, suspect that
first, and the fix is a bootloader without the timeout, not a different circuit.

---

## Bench test, in order

Each step answers a question the next one depends on. These are live procedures — they apply to the
perfboard build as much as they applied to the board this file was written for.

1. **Identify the four NUC wires with a meter** (section above). Write down which is which.
2. **Set the module to 12.0 V with a meter** before it is wired to anything, and check its current
   limit is released (section above). Then confirm 5 V and 3.3 V.
3. **Find the fan's stall duty.** Synthesize the ITE's demand instead of buying a PWM box: a
   10 kΩ multi-turn pot across +3V3 and GND, wiper to A0, is a 0–100 % duty knob the sketch
   reads through the same divider it will read in service. Watch `duty_fan` on the serial line
   and the fan itself at 25 %, then 20 %, then 15 %, and write down where it stops. That number
   becomes `FAN_DUTY_MIN`. The sketch never commands below it: the fan idles at its stall duty
   rather than stopping, because a stopped fan whose tach still claims 700 RPM is a lie the ITE
   would never catch and the CPU would pay for.
4. **Measure the fan at two duties.** Point a phone camera at the hub in 240 fps slow-motion
   (or an optical tachometer) at 40 % and at 100 % duty, count blade passes per second × 60 /
   blade count. Those two numbers become `FAN_RPM_MIN` (at `FAN_DUTY_MIN`) and `FAN_RPM_FULL`.
5. **Power the board from the bench supply** — 19 V into J1 with the module wired onto J6, or
   12 V straight onto J6 pins 4 and 1 when the module is not on the bench (its output side is no
   longer a switching node, so feeding it directly is a legitimate way to test the control half).
   Current-limit the supply either way. Confirm the LED blinks at 1 Hz and the serial line prints.
6. **Read TP1 with a frequency counter** with the sketch running: it should sit at
   `rpm / 30` Hz to the last digit. It is a hardware timer, so a mismatch means a wiring
   error, not drift.
7. **Then connect the tach side to the NUC only** (J2.1 and J2.2; leave J2.3 and J2.4 open)
   and read the RPM in BIOS or hwmon. If the number appears, Q1's open-collector drive and the
   ITE's pull-up agree with each other.
8. **Read the BIOS number against the claim, and set `ITE_READ_GAIN` from it.** The ITE's counting
   window is not exactly one second and the driving board's oscillator is not exactly 8 MHz, so
   the BIOS number is never the emitted one. On a breadboard Uno into this NUC, a claim of 1200
   RPM (40.000 Hz at TP1) read as **1188** — 0.9900 exactly. Scope TP1 while you read the BIOS: if
   the scope shows the emitted frequency and the BIOS sits 1 % under, the gap is the ITE's gate
   and the gain belongs in firmware; if the scope also sits 1 % under, the gap is the oscillator,
   and the number to fix is this board's own, measured here, not the Uno's.
9. **Then add the PWM wire** (J2.3) and watch the serial line while you load the machine
   (`yes > /dev/null` on every core). `duty_in` should climb with the fan demand the BIOS is
   asking for. If it stays flat, the PWM wire is not where you thought it was.
10. **Only then** connect the fans to J7/J3/J4, and only then cut and splice the stock fan cable.

Step 7 before step 9 before step 10 matters: if something is wrong on the tach line, you want
it wrong while the board is driving nothing but a signal.

Calibration is then two numbers. At idle and at full load, read the fan's real RPM and the
sketch's `rpm`; if the sketch reports too much or too little, move `FAN_RPM_MIN` /
`FAN_RPM_FULL`, not the tach floor or ceiling.

### Three things the numbered list does not cover: the divider, its top, and its edge

**The divider's ratio is settled: two 10 kΩ, confirmed by the builder.** The tap is exactly half the
PWM line, so on the Uno — whose ADC reference is its own 5 V rail — 100 % duty is 512 counts, and every
duty number in `bench/data/` is read on that scale. `firmware/probe-divider` stays in the tree as the
check to run whenever a different pair goes on the bench: feed the chain from the Uno's own 5 V pin, and
because excitation and ADC full scale share a rail the rail voltage cancels and `counts ÷ 1024` *is* the
ratio.

That makes the case for changing the board's divider to 10 kΩ / 10 kΩ too, and it is worth making:
2.50 V on the tap instead of 2.96 V (0.8 V of headroom on a 3.3 V part instead of 0.34 V), one fewer
resistor, 0.25 mA of load on the ITE instead of 0.30 mA, τ = 5 kΩ × 1.1 µF = 5.5 ms against a 43.5 µs
period, and 775 counts for 100 % on the 3.3 V rail. The bench and the board would then read the same
scale. Until that change is made the schematic's divider is what `ADC_AT_100PCT = 918` describes.

**The top of the PWM swing, from the dwell ladder.** The flat top (5.0 V or 5.5 V) decides whether 100 %
lands at 918 or 1009 counts on the board's present divider, and it cannot be got from a single average
reading because the duty at that moment is unknown. It can be got from *differences*, and the fourth bench
run produced four consecutive dwell levels instead of two. On the confirmed 0.500 ratio:

    198 counts = 0.969 V at A0 = 1.938 V average on the PWM wire
    257 counts = 1.255 V at A0 = 2.510 V average on the PWM wire
    320 counts = 1.563 V at A0 = 3.125 V average on the PWM wire
    380 counts = 1.857 V at A0 = 3.711 V average on the PWM wire

Successive differences 0.572, 0.615, 0.586 V — mean 0.595 V, 60.9 counts. A straight line through the four
is `counts = 15 + 61 k` for k = 3, 4, 5, 6, and the hottest samples in the log reach 434 counts against the
441 that k = 7 predicts. So the ITE's quantum is 1/8, it sits on 3/8 with the board cold and reaches 6/8 or
7/8 with the board at 68 °C — and the same line extrapolated to the ends says 15 counts (0.14 V) at zero
duty and **502 counts (4.90 V) at 8/8**. That is the answer the two-level arithmetic could not give: the
top is nearer 4.9 V than 5.5 V, and 100 % lands within 2 % of 512 counts rather than at 1009.

What is still open is the 15-count offset at zero — the ITE's output offset, or something in the reading —
and whether the top sags under load at the high dwell. Resistor tolerance is the limit on this arithmetic:
a 5 % mismatch inside the pair moves the inferred average by 5 %, which is 0.03 V of the 0.60 V step.
Measuring the levels with the meter, and the two resistors as well, closes both.

**Scoping the line: the top and the rising edge.** The one number still carried from an ambiguous capture
is the ITE's flat top — 5.5 V was read once, and a 5.5 V, 30 ns spike is a different thing from a 5.5 V
flat top. The Hantek settles both, and the Uno supplies the missing half of the arithmetic.

1. **10× probe, DC coupled, 1 V/div, 20 µs/div.** A 1× probe adds ~100 pF across the line and slows the
   edges it is being asked to measure. 23 kHz is a 43.5 µs period, so two divisions shows a whole cycle,
   and 1 V/div puts a 5 V swing over five divisions — the finest vertical scale that still fits it, which
   is what makes the average reading good enough to divide by.
2. **Shortest possible ground.** The probe's own spring ground on the header's ground wire, not the long
   lead with the alligator clip. A 15 cm ground lead is a loop-and-a-capacitor that manufactures
   overshoot on a 23 kHz edge, which is exactly the artefact being looked for.
3. **The flat top, from two instruments at once.** Read `Avg` on the scope and, at the same moment, the
   `adc` count the Uno is printing. Duty is `adc / 512`, so

       top = scope Avg ÷ (adc / 512)

   At the cold high dwell (257 counts, 50.2 %) a 5.0 V top predicts 2.51 V average and a 5.5 V top
   predicts 2.76 V — 0.25 V apart, a quarter of a division at 1 V/div, which is outside what the scope's
   own DC accuracy wanders. At the hot dwell (380 counts, 74.2 %) the same two predict 3.71 V and 4.07 V,
   and the ladder's own answer — 4.90 V — predicts 3.66 V, so the hot dwell is where 4.9 V, 5.0 V and
   5.5 V are easiest to tell apart. Measure the two resistors with the meter as well: their tolerance is
   what limits `adc / 512`.
4. **The rising edge, single-shot.** Trigger on the PWM edge at 2.5 V, then 200 ns/div, and read the
   10–90 % time and the peak. A 4-wire fan's PWM input is a few kΩ to ground with tens of pF, so with
   the stock blower still on the header the edge is RC-limited and ringing that survives is the line,
   not the probe. Compare the peak with the blower disconnected: if the top rises when the load comes
   off, the ITE's output is open-drain with a pull-up, and the loaded top is the one the divider sees in
   service.

Both readings belong in `bench/data/` as a note beside the log they were taken with.

---

## Known limits

- **The tach is a claim, not a measurement.** The board derives the reported RPM from the duty
  it is applying, so it is only honest if the fan really spins at that RPM. If the fan is
  gummed up or the wrong fan is fitted, the board will report a speed that does not exist —
  which is exactly what the ITE cannot tell apart.
- **The 12 V is somebody else's converter.** The buck is a finished module (XL4016E1, cabinet L1 A10) and
  the numbers in this document are the ones its catalogue record carries — 5–40 V in, 1.2–36 V out, 8 A
  continuous, ~180 kHz, ~50 mV ripple — not measurements taken here. There is no data sheet for the module
  board itself, only for the XL4016E1 IC on it (LCSC C55881). What has never been measured on this rail is
  the module's real output ripple, its no-load draw, and whether its CC trimmer is released — and that last
  one is the failure that can quietly break the fan control, so the meter test in *Set the module to 12.0 V*
  is not optional.
- **The ITE's PWM is measured, not assumed: 23 kHz square, 45 % duty mid-sweep.** A scope on this
  NUC's fan header reads 23 kHz, inside Intel's 25 kHz ±10 % for a 4-wire fan. The divider and
  C10/C11 are comfortably right at that frequency: 4.08 kΩ Thévenant at the node against 1.1 µF
  gives τ = 4.49 ms against a 43.5 µs period, so the ripple at the ADC is 7 mV — 2.2 counts,
  0.24 % of the duty span — before the sketch's 16-sample average. Had the line really been
  1.56 kHz, the same network would have carried 116 mV, 3.6 % of the span, and C10 would have had
  to become 4.7 µF. It does not.
- **A 5.5 V peak is harmless; a 5.5 V flat top is not free.** A 0.5 V, 30 ns overshoot spike moves
  the filtered node about 3 mV (3.7 nC of charge into 1.1 µF), so ringing does not touch the duty
  read. The flat top does: 5.0 V puts 100 % duty at 918 counts, 5.5 V puts it at 1009 — 1.4 % from
  full scale. A multimeter settles it without a scope: DC volts on the PWM wire reads the average,
  and average ÷ duty = flat top, so 45 % duty gives 2.25 V (top 5.0) or 2.47 V (top 5.5). If it is
  5.5 V, R5 drops from 10 kΩ to 8.2 kΩ and 100 % lands at 930 counts with 10 % headroom. It is
  still the one thing on this board that has to be re-checked if a different NUC generation puts
  12 V on that line (rule 4 above). The bench already provides the numbers a meter should reproduce:
  on the confirmed 0.500 divider the ITE's four dwell levels — 198, 257, 320 and 380 counts — average
  **1.94 V, 2.51 V, 3.13 V and 3.71 V** on the PWM wire, with 0.97 V, 1.26 V, 1.56 V and 1.86 V at the tap.
- **The ITE's PWM demand answers the board's temperature, not the cores, and not the tach.** Measured
  five times on this NUC6i3SYB: the third measurement corrected the second, and the fourth killed the
  integrator theory.

  *The tach.* A 40 s ladder of claims (800 / 2000 / 4500 RPM, fan drive pinned at 90 %) moved the ITE's
  requested duty from 233.6 to 231.0 counts — a 5.6× swing in claimed RPM for 2.5 counts out of 233
  (−1.1 %), while the same claim swung 195–260 on its own. The reported speed is not in the loop.

  *Temperature, first run.* The claim frozen at 1500 RPM (50.000 Hz) for 427 s while the package was
  driven 55 → 83 → 53 °C, the bench fans switched in by hand. The divider reading tracked the package at
  **r = +0.822 with a 4 s lag**: 231 counts at 55 °C, 327 at 81 °C, back to 230 at 53 °C. The same
  temperature on the way up and on the way down agreed (80–85 °C: 321 up, 328 down), so it was a response
  and not drift. What that run could not separate is *which* temperature: with weak airflow the board and
  the cores rose together — PCH 52 → 63.5 °C alongside the package's 53 → 83 °C.

  *Temperature, second run — the one that decides.* Same sketch, the same frozen claim, the bench fans at
  maximum. `stress-ng --cpu 4` for 300 s took the package 34 → 73 °C and it cooled back to 38 °C; the PCH
  only reached 55.5 °C. **The demand did not move:** 195–260 counts for the whole eleven minutes, the same
  band it sits in at 34 °C, correlated with the package at r = +0.049 and with the PCH at +0.065. The
  cores got hot and the ITE did not care.

  *Temperature, third run — the top end, and the release.* Same sketch, same frozen claim, the opposite
  airflow arrangement: the bench fans off entirely, the NUC's own blower at minimum, and the board warmed by
  hand before the load. `stress-ng --cpu 4` for 240 s pinned the package at 87–88 °C while the board reached
  **68.5 °C**, and this time the demand climbed out of the floor: 259 counts as the board passed 57 °C, 319
  at 60–63 °C, **380 counts (74 %, 3.71 V on the wire) at 66–69 °C**, with 434 counts (85 %) seen. Then the
  load was stopped and everything left alone, and the demand fell back — 381 → 242 counts within 30 s of the
  board dropping back through 55 °C. The board and the cores were collinear in this run, so it does not
  separate them; it extends the curve at the top and measures the response time.

  *Temperature, fourth run — the hold.* Same sketch, same frozen claim, same airflow. A 300 s four-core
  ramp to get the board past the knee, then **1200 s at a two-core load**, then 300 s left alone. The board
  settled at 68.5–69.0 °C and stayed there for sixteen flat minutes with the package at 84–86 °C, and the
  demand sat at **378 counts** — the same rung the third run found at the same board temperature,
  repeatable to 2 counts. See the integrator test below; the point here is that the top of the curve
  reproduces.

  Pool the five runs and bin by the board, and the picture is monotone where binning by the cores is not:

  | board (`pch_thermal`) | n | median counts | duty at 512 | PWM wire average | package in those samples |
  |---|---|---|---|---|---|
  | 33–51 °C | 2 131 | 239 | 46.7 % | 2.33 V | 42 °C |
  | 51–54 °C | 306 | 247 | 48.2 % | 2.41 V | 53 °C |
  | 54–57 °C | 251 | 254 | 49.6 % | 2.48 V | 58 °C |
  | 57–60 °C | 169 | 259 | 50.6 % | 2.53 V | 75 °C |
  | 60–66 °C | 365 | 319 | 62.3 % | 3.12 V | 80 °C |
  | 66–72 °C | 1 352 | 377 | 73.6 % | 3.68 V | 85 °C |

  The discriminating subset is 247 samples with the cores at 68.7 °C and the board at 51.0 °C: median 243
  counts, 47 %, none above 261 — the number the ITE asks for when everything is cold. The mirror subset,
  134 samples with the cores under 55 °C and the board at 52 °C or more, sits at 243 counts: the board has
  to pass about 55 °C before the ITE moves. `bench/analyze-heat.py` reproduces these tables from
  `bench/data/`, and `bench/plot-curve.py` draws them as `docs/bench/06-ite-fan-response.svg`.

  Two claims from before the fourth run are retired. The 297 counts at 57–60 °C was not a level the ITE
  holds — 285–314 counts account for 34 samples out of 2 777 while 315–319 account for 89 — it was the ramp
  passing through, so "+10.5 counts per °C, 2.0 duty points per °C" describes a transition, not a curve: the
  ITE steps between 198, 257, 320 and 380. And the response is not equally fast in both directions: about
  **75 s** to reach the plateau after the board crossed the knee, about **30 s** to let go of it on the way
  down. `DEMAND_TAU_S = 15 s` sits inside both, which is the point — the follower must be quicker than the
  ITE's own response without chasing its 1–3 s dwell switching.

  Two things follow for the build. The fan this board drives sits **inside** the ITE's loop: the fan
  cools the board, the ITE reads the board, the ITE changes the demand. And the ITE sits at its floor
  quite happily while the cores are at 73 °C, so the enclosure has to move air across the board and the
  ITE's own ambient sensor — the BIOS screen's "motherboard ambient", 40 °C against a CPU at 58 °C — and
  not only over the heatsink. A fan that leaves the board warm will be told, by the ITE itself, to speed
  up; one that cools the board will be told to slow down.
- **The ITE's demand is not an integrator: time at temperature buys nothing.** The theory that the ITE
  keeps raising its duty as long as the temperature refuses to fall — a step-up timer, maybe accelerating
  past a threshold — is what the hold run was built for, and it is dead on this machine. Three reads
  (`bench/analyze-hold.py`, figure `docs/bench/07-ite-hold-test.svg`):

  * Across the 16 windows of the hold in which the board held within 0.8 °C of its 68.5–69 °C plateau, the
    demand trended **+0.6 counts per minute**, while the board's own +0.07 °C per minute drift already
    explains +1.5 counts per minute at the ladder's 20.3 counts per °C. Nothing is left for time to explain.
  * The same board temperature reached quickly against reached and held: 63–66 °C gives 342 counts on the
    ramp and **319** in the hold; 66–69 °C gives 378 and **368**. Later is *lower*.
  * Fitting the 1 513 samples above 55 °C on board temperature and seconds since the knee was crossed:
    temperature alone R² 0.669, plus time R² 0.670 with a coefficient of **−0.00 counts per minute**.

  What the ITE does instead is settle. Early in the hold the reading swung 318–380 counts, dipping to the
  rung below; by the end the dips had shrunk to 346–381 and the mode was 379 throughout. And the ramp
  overshoots: 342 counts at 63–66 °C on the way up against 319 at the same temperature in the hold, which
  says the ITE answers how fast the board is moving as well as where it is — the same asymmetry the third
  temperature run measured as 75 s to climb and 30 s to release. For the build: `DEMAND_TAU_S` does not
  have to outwait a controller that ramps on a timer, because this one does not ramp on a timer.
- **The ITE's demand has a floor, and it is nowhere near zero.** With the bench fans at maximum the
  package sat at 32–36 °C for twelve minutes — 21 °C below the plateau the first temperature run had been
  stuck at — and the requested duty did not follow it down: 196–260 counts, median 239, and not one
  sample of 717 below 100 counts. The floor runs from the coldest measured board up to a PCH of about
  54 °C — 1 946 samples of it — at 46–48 % duty and 2.33 V on the PWM wire. So `FAN_DUTY_MIN` is a clamp
  against a broken sense wire rather than something the ITE ever reaches, and a fan that is always turning
  is a fan whose tach claim is always plausible.
- **The demand is stepped, not analog, and the ITE cycles between the steps.** The dwell levels across all
  five runs are 198, 257, 320 and 380 counts — spaced 59–63 — held for 667, 1 120, 321 and 826 samples of
  4 577, with everything else either a ramp between them or the ITE's own drift, and the hottest samples
  reaching 434 against the 441 the spacing predicts for the next rung. Read as 512 counts = 100 % they are
  38.8 %, 50.2 %, 62.5 % and 74.2 %: 3/8, 4/8, 5/8
  and 6/8 within 0.7 duty points, which is what a fan controller with a binary duty quantum looks like.
  Read as 605 they are 32.7 %, 42.5 %, 52.9 % and 62.8 %, a 10.1 point step that matches no binary quantum —
  one more reason to run the ratio test above. It moves fast, too: 535 of 716 seconds changed by more than
  3 counts, and a dwell switches to the other dwell in 1–3 s. That is why
  `DEMAND_TAU_S` is 15 s and `DEMAND_DEADBAND` is 1.5 points. Chasing the cycle with a 300 ms pole
  would pump the fan at 0.3 Hz while the machine's own thermal time constant is minutes. The cycle is
  the ITE closing its loop through the fan: it asks for more duty, the board cools, it asks for less. A
  follower that answers sharply sharpens that cycle; a slow one lets the ITE regulate at its own pace.
- **The ITE's fan block is not reachable from Linux on this NUC.** `it87` refuses with `No such
  device`: the BIOS enumerates only the CIR (ITE8713) and RTC logical devices of the SuperIO, so
  there is no `fan1_input` or `pwm1` to read, and Debian 13 packages no `superiotool`. The ITE's own
  RPM number has to be read on the BIOS screen, which is why the sweep puts its rungs 4.6 RPM apart
  at the 3000 claim — wider than the ITE's 2 RPM display step.
- **Two-pin fans have no tach.** There is no way to confirm the fan is turning other than
  looking at it, or adding a separate tach wire and a 10 kΩ pull-up to +12 V and reading it
  off a spare ADC pin (A1 is free on J5 if you want it — there is no pin on the header today).
- **The ITE stops counting above ~11 000 RPM** and calls a fan stalled after 1–2 s without
  pulses; Timer1's own floor on an 8 MHz board is 229 RPM, so the ITE's limits are the binding
  ones in both directions.
- **The 3.3 V Pro Mini must be the 8 MHz one.** The ATmega328P's speed grade reaches 8 MHz at
  2.7–5.5 V (automotive table) or 10 MHz (industrial table); 16 MHz needs 4.5 V. A 3.3 V board
  carrying a 16 MHz crystal — a common clone — runs the chip outside its datasheet, and a
  crystal outside its spec is a crystal that can fail to start when the machine is cold. Check
  the marking before ordering.
- **Mode A still exists** (`firmware/nuc-tach-modeA/`, `archive/modeA-2026-10-19/`) if you ever
  want the fixed-RPM lie again. It does not run on this board: it has no fan drive and no duty
  read, and its Pro Mini header is 3 pins, not 5.
