kavehs87/nuc-fan-controller/fan-switch-booster/docs/mosfet-fan-switch.pdf

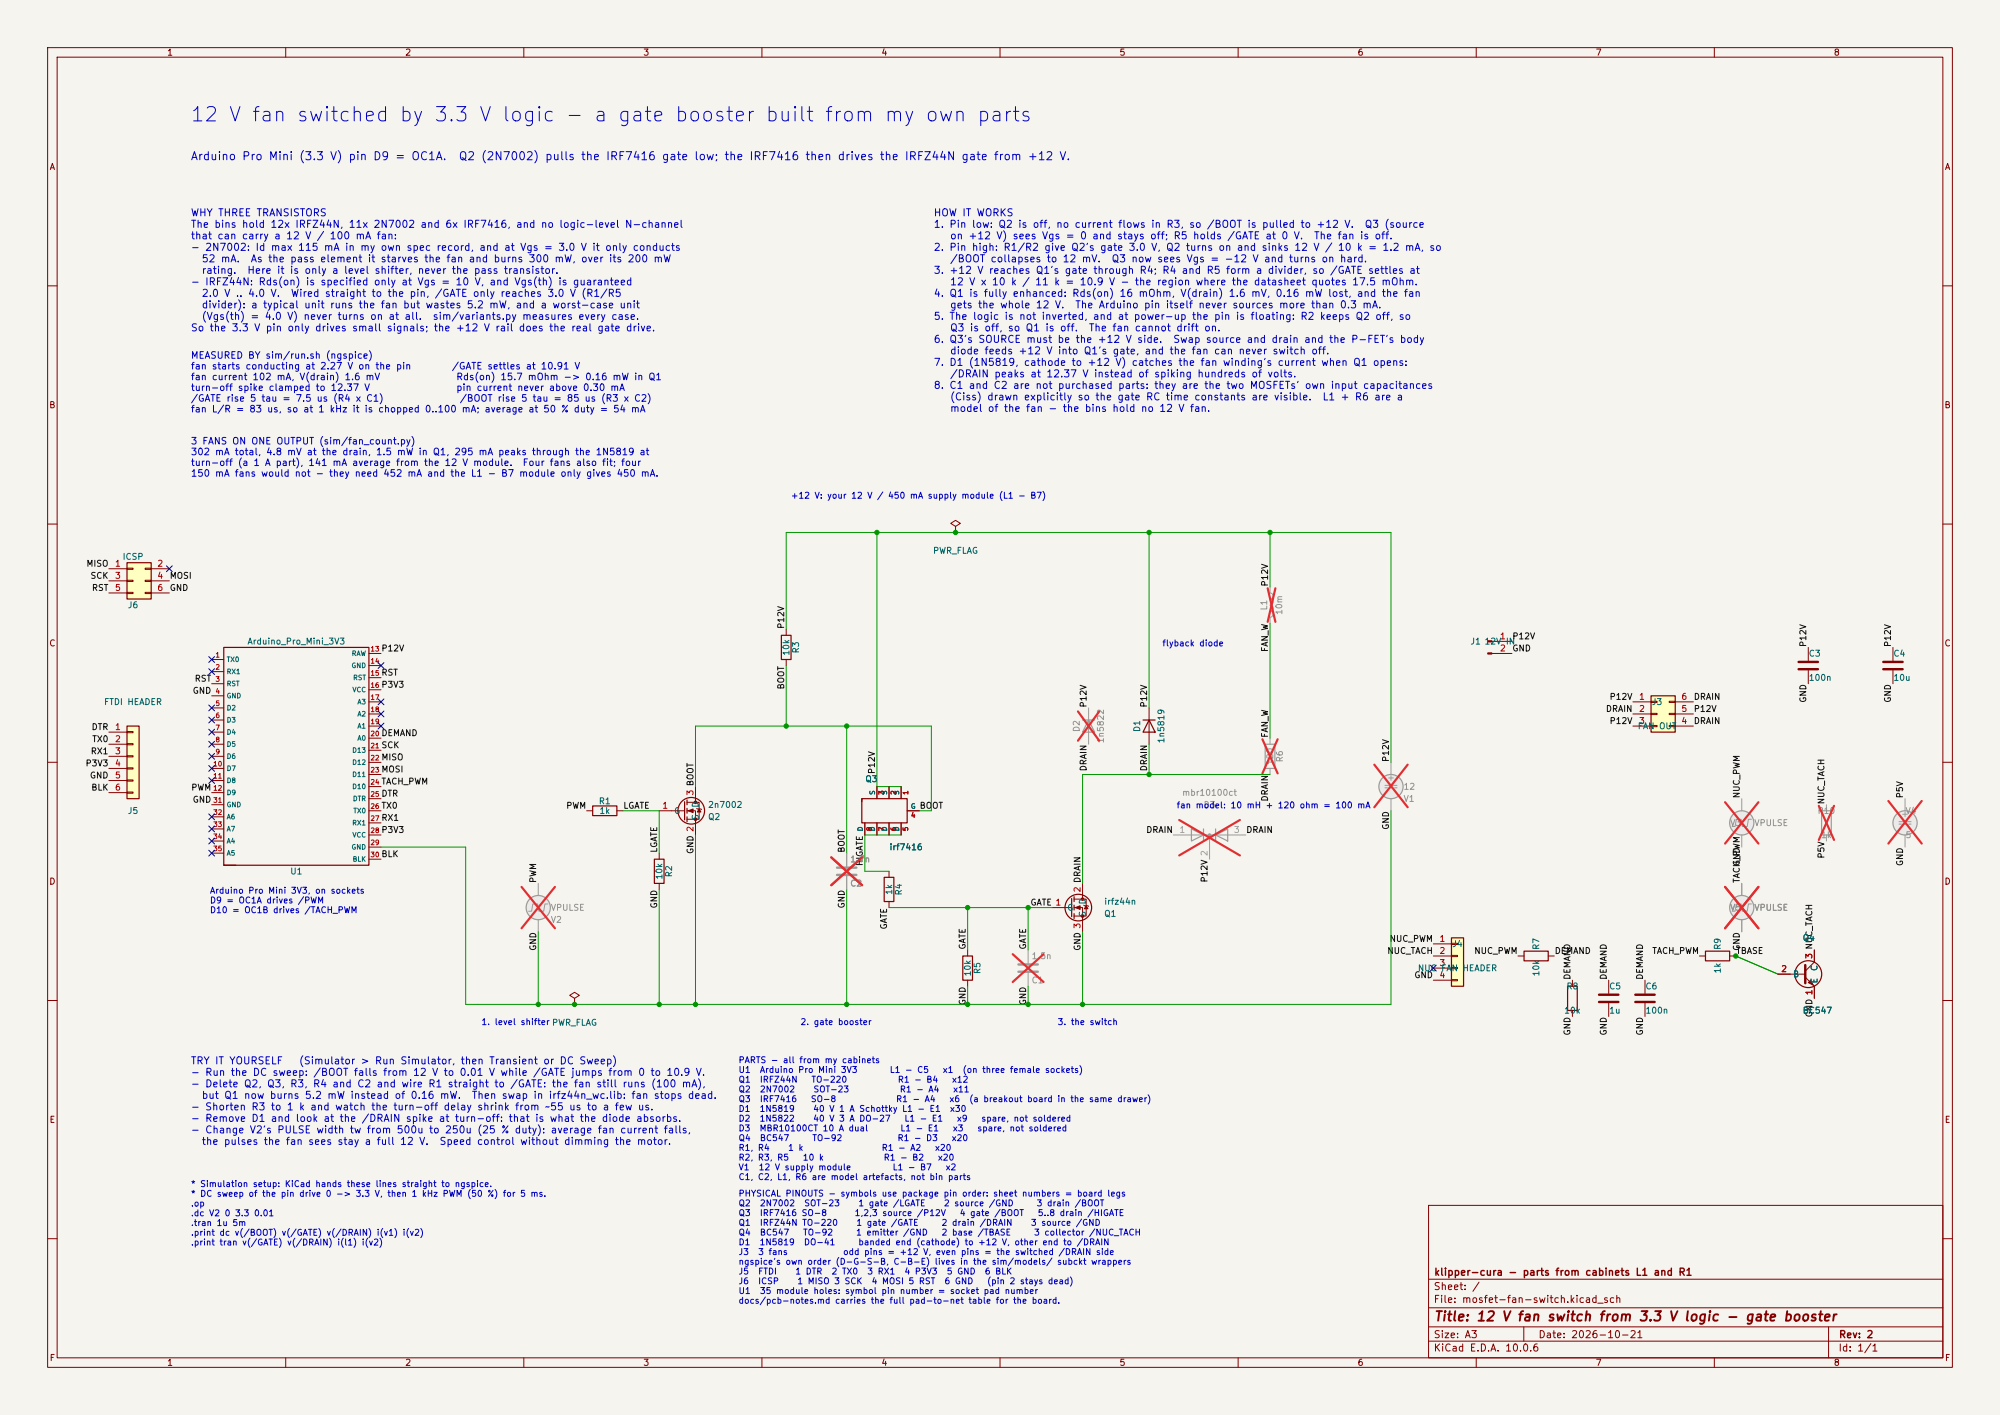
[picture p9: page 1]
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

Arduino Pro Mini (3.3 V) pin D9 = OC1A. Q2 (2N7002) pulls the IRF7416 gate low; the IRF7416 then drives the IRFZ44N gate from +12 V.

fan L/R = 83 us, so at 1 kHz it is chopped 0..100 mA; average at 50 % duty = 54 mA WHY THREE TRANSISTORS
The bins hold 12x IRFZ44N, 11x 2N7002 and 6x IRF7416, and no logic-level N-channel
that can carry a 12 V / 100 mA fan: - 2N7002: Id max 115 mA in my own spec record, and at Vgs = 3.0 V it only conducts

HOW IT WORKS
1. Pin low: Q2 is off, no current flows in R3, so /BOOT is pulled to +12 V. Q3 (source on +12 V) sees Vgs = 0 and stays off; R5 holds /GATE at 0 V. The fan is off.

2. Pin high: R1/R2 give Q2's gate 3.0 V, Q2 turns on and sinks 12 V / 10 k = 1.2 mA, so /BOOT collapses to 12 mV. Q3 now sees Vgs = -12 V and turns on hard.

52 mA. As the pass element it starves the fan and burns 300 mW, over its 200 mW
rating. Here it is only a level shifter, never the pass transistor. - IRFZ44N: Rds(on) is specified only at Vgs = 10 V, and Vgs(th) is guaranteed

3. +12 V reaches Q1's gate through R4; R4 and R5 form a divider, so /GATE settles at
12 V x 10 k / 11 k = 10.9 V - the region where the datasheet quotes 17.5 mOhm.
4. Q1 is fully enhanced: Rds(on) 16 mOhm, V(drain) 1.6 mV, 0.16 mW lost, and the fan
gets the whole 12 V. The Arduino pin itself never sources more than 0.3 mA.
5. The logic is not inverted, and at power-up the pin is floating: R2 keeps Q2 off, so Q3 is off, so Q1 is off. The fan cannot drift on. 6. Q3's SOURCE must be the +12 V side. Swap source and drain and the P-FET's body

2.0 V .. 4.0 V. Wired straight to the pin, /GATE only reaches 3.0 V (R1/R5
divider): a typical unit runs the fan but wastes 5.2 mW, and a worst-case unit
(Vgs(th) = 4.0 V) never turns on at all. sim/variants.py measures every case. So the 3.3 V pin only drives small signals; the +12 V rail does the real gate drive.

turn-off (a 1 A part), 141 mA average from the 12 V module. Four fans also fit; four 150 mA fans would not - they need 452 mA and the L1 - B7 module only gives 450 mA. MEASURED BY sim/run.sh (ngspice)

diode feeds +12 V into Q1's gate, and the fan can never switch off.
7. D1 (1N5819, cathode to +12 V) catches the fan winding's current when Q1 opens:
/DRAIN peaks at 12.37 V instead of spiking hundreds of volts.
8. C1 and C2 are not purchased parts: they are the two MOSFETs' own input capacitances

(Ciss) drawn explicitly so the gate RC time constants are visible. L1 + R6 are a model of the fan - the bins hold no 12 V fan. +12 V: your 12 V / 450 mA supply module (L1 - B7) Q3

3 FANS ON ONE OUTPUT (sim/fan_count.py) 302 mA total, 4.8 mV at the drain, 1.5 mW in Q1, 295 mA peaks through the 1N5819 at

klipper-cura - parts from cabinets L1 and R1 10k R3

Arduino Pro Mini 3V3, on sockets D9 = OC1A drives /PWM

but Q1 now burns 5.2 mW instead of 0.16 mW. Then swap in irfz44n_wc.lib: fan stops dead. - Shorten R3 to 1 k and watch the turn-off delay shrink from ~55 us to a few us. - Remove D1 and look at the /DRAIN spike at turn-off: that is what the diode absorbs. - Change V2's PULSE width tw from 500u to 250u (25 % duty): average fan current falls,

the pulses the fan sees stay a full 12 V. Speed control without dimming the motor.

* Simulation setup: KiCad hands these lines straight to ngspice. * DC sweep of the pin drive 0 -> 3.3 V, then 1 kHz PWM (50 %) for 5 ms.

.tran 1u 5m
.print dc v(/BOOT) v(/GATE) v(/DRAIN) i(v1) i(v2)

Sheet: /
File: mosfet-fan-switch.kicad_sch
Title: 12 V fan switch from 3.3 V logic - gate booster

Size: A3 | Rev: 2 | F Date: 2026-10-21
KiCad E.D.A. 10.0.6 | Id: 1/1
