kavehs87/nuc-fan-controller/fan-switch-booster/docs/pcb-assembly-bottom.pdf

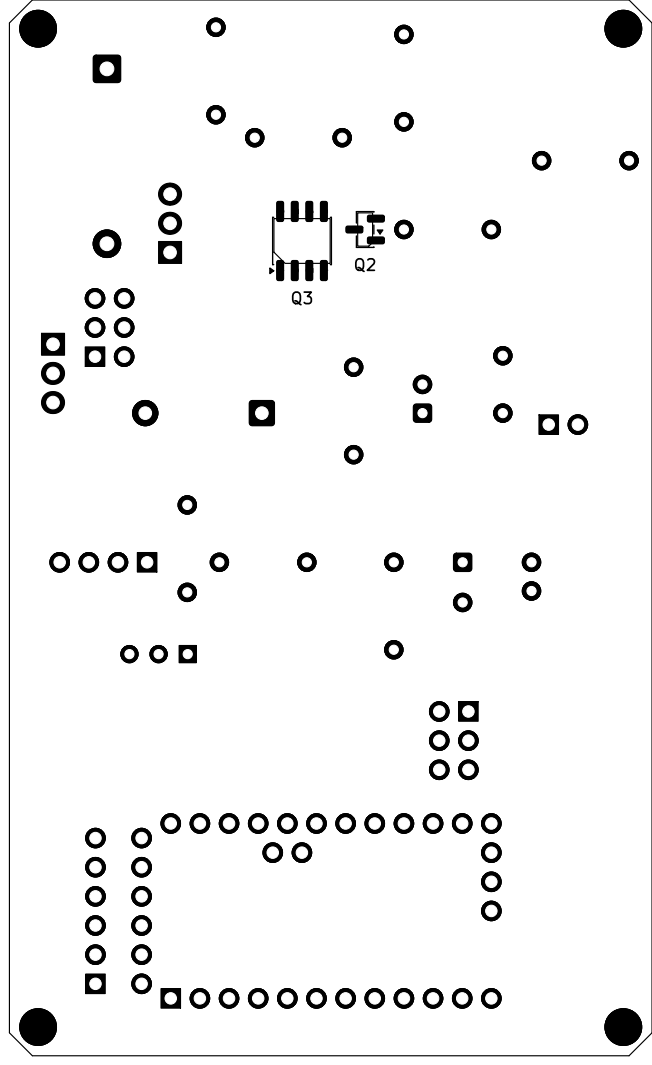
[picture p10: page 1]
