kavehs87/nuc-fan-controller/fan-switch-booster/docs/pcb-assembly-top.pdf

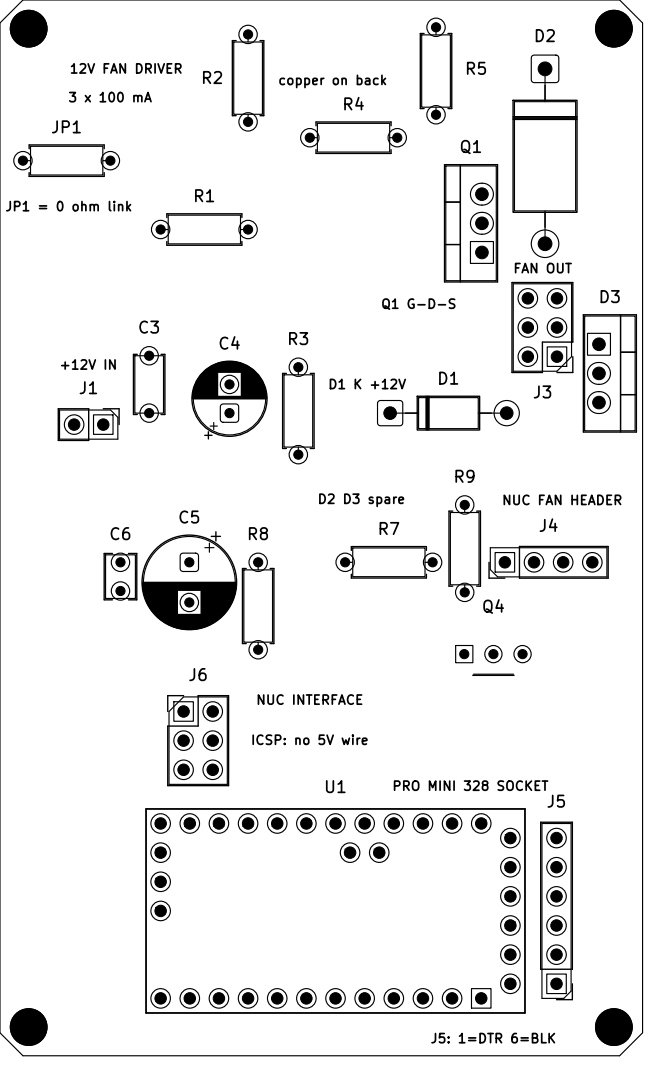
[picture p11: page 1]
