kavehs87/nuc-fan-controller/fan-switch-booster/docs/pcb-etch-bottom.pdf

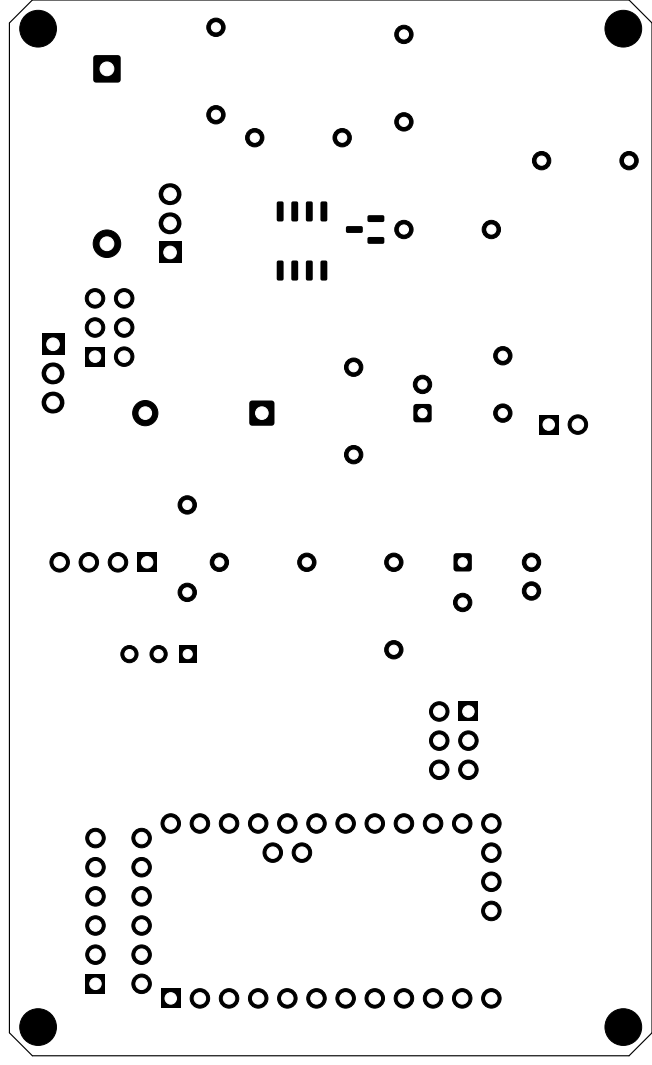
[picture p12: page 1]
