kavehs87/nuc-fan-controller/fan-switch-booster/mosfet-fan-switch.kicad_pcb

## KiCad design fan-switch-booster/mosfet-fan-switch.kicad_pcb (2026-10-24)

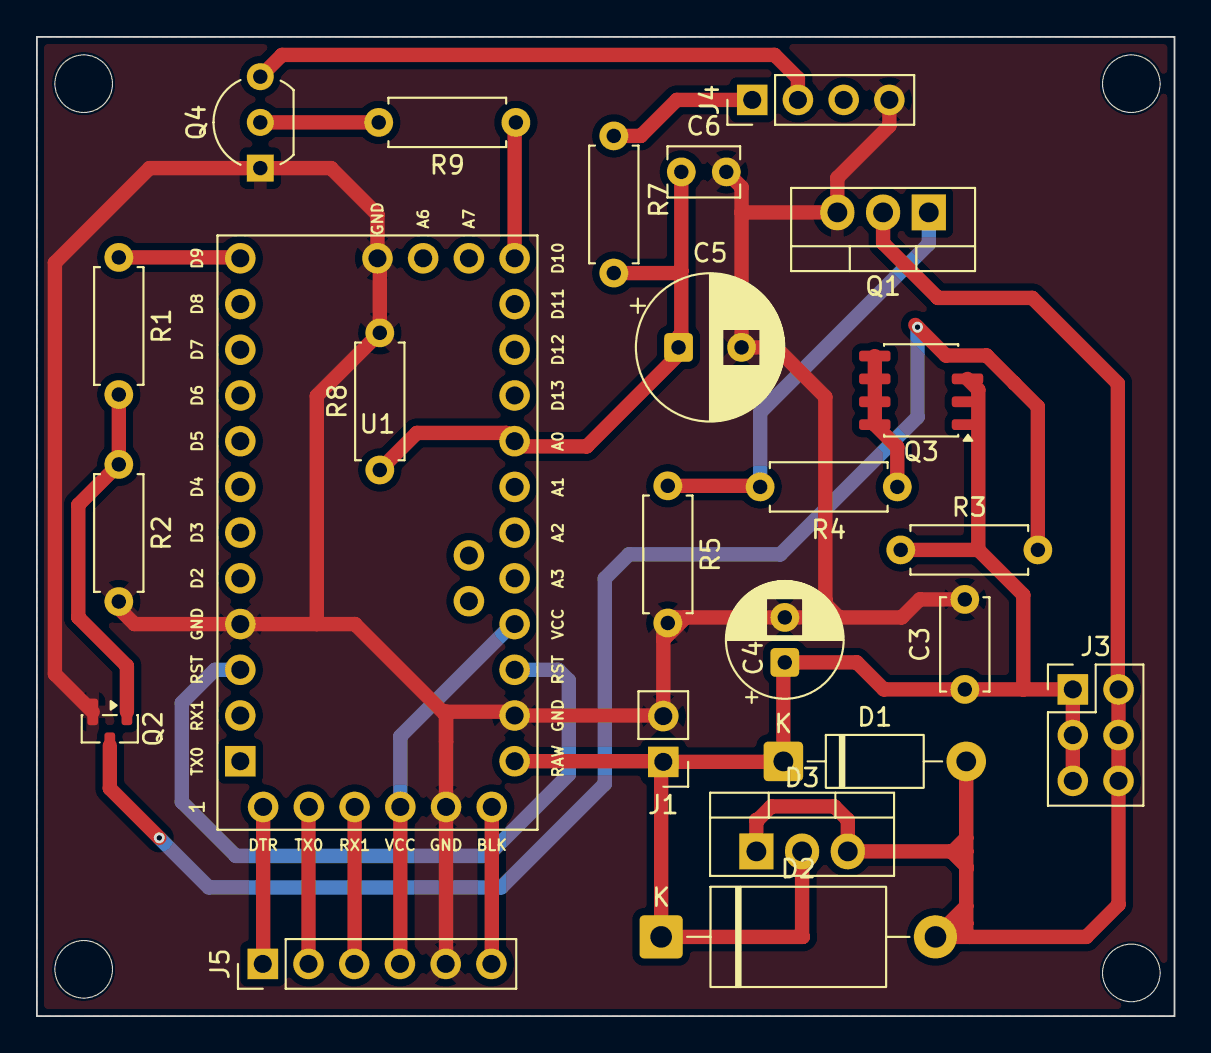
[picture p13: board mosfet-fan-switch.kicad_pcb from above]

Board: 2 copper layers, 63.2 x 54.4 mm, 28 parts (0 on the bottom side), 19 nets.

Parts:
C3: 100n; C_Disc_D5.0mm_W2.5mm_P5.00mm
C4: 10u; CP_Radial_D6.3mm_P2.50mm
C5: 1u; CP_Radial_D8.0mm_P3.50mm
C6: 100n; C_Disc_D3.8mm_W2.6mm_P2.50mm
D1: 1n5819; D_DO-41_SOD81_P10.16mm_Horizontal
D2: 1n5822; D_DO-27_P15.24mm_Horizontal
D3: mbr10100ct; TO-220-3_Vertical
J1: 12V IN; PinHeader_1x02_P2.54mm_Vertical
J3: FAN OUT; PinHeader_2x03_P2.54mm_Vertical
J4: NUC FAN HEADER; PinHeader_1x04_P2.54mm_Vertical
J5: FTDI HEADER; PinHeader_1x06_P2.54mm_Vertical
MK1, MK2, MK3, MK4: M3 mounting hole; MountingHole_3.2mm_M3
Q1: irfz44n; TO-220-3_Vertical
Q2: 2n7002; SOT-23
Q3: irf7416; SO-8_3.9x4.9mm_P1.27mm
Q4: BC547; TO-92_Inline_Wide
R1, R4, R9: 1k; R_Axial_DIN0207_L6.3mm_D2.5mm_P7.62mm_Horizontal
R2, R3, R5, R7, R8: 10k; R_Axial_DIN0207_L6.3mm_D2.5mm_P7.62mm_Horizontal
U1: Arduino_Pro_Mini_3V3; Arduino_Pro_Mini_328_Socket

Connections:
/BLK: J5.6, U1.30 (BLK)
/BOOT: Q2.3 (D), Q3.4 (G), R3.2
/DEMAND: C5.1, C6.1, R7.2, R8.1, U1.20 (A0)
/DRAIN: D1.2 (A), D2.2 (A), D3.1 (A), D3.3 (A), J3.2, J3.4, J3.6, Q1.2 (D)
/DTR: J5.1, U1.25 (DTR)
/GATE: Q1.1 (G), R4.2, R5.1
/GND: C3.2, C4.2, C5.2, C6.2, J1.2, J4.4, J5.5, Q1.3 (S), Q2.2 (S), Q4.1 (E), R2.2, R5.2, R8.2, U1.4 (GND), U1.14 (GND), U1.29 (GND), U1.31 (GND)
/HIGATE: Q3.5 (D), Q3.6 (D), Q3.7 (D), Q3.8 (D), R4.1
/LGATE: Q2.1 (G), R1.2, R2.1
/NUC_PWM: J4.1, R7.1
/NUC_TACH: J4.2, Q4.3 (C)
/P3V3: J5.4, U1.16 (VCC), U1.28 (VCC)
/P12V: C3.1, C4.1, D1.1 (K), D2.1 (K), D3.2 (K), J1.1, J3.1, J3.3, J3.5, Q3.1 (S), Q3.2 (S), Q3.3 (S), R3.1, U1.13 (RAW)
/PWM: R1.1, U1.12 (D9)
/RST: U1.3 (RST), U1.15 (RST)
/RX1: J5.3, U1.27 (RX1)
/TACH_PWM: R9.1, U1.24 (D10)
/TBASE: Q4.2 (B), R9.2
/TX0: J5.2, U1.26 (TX0)
