kavehs87/nuc-fan-controller/(commit log)

2026-10-19 nuc-fan-controller: 19V->12V buck + 5V/3.3V chain + PWM-following 12V fan drive + tach simulator
    Replaces the Mode A fixed-RPM tach simulator (kept in archive/modeA-2026-10-19).
    Audit fixes applied in this commit:
    - R3 (4.7k) had both ends on NUC_PWM: the divider was R4+R5 only, which puts 4.10 V on A0,
    over the ATmega328P's VCC+0.5 V absolute max. R3's far end is now its own net (PWM_DIV)
    in the schematic and on the board, so the divider is 10/(4.7+2.2+10) = 0.592 -> 2.96 V.
    genwires.py now reports any part with both ends on one net, so this cannot come back.
    - The Power net class patterns still named the pre-rename nets (Net-(C1-Pad1) and friends),
    which left 19V, SW and FAN_SW -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
    [nuc-fan-controller-B_Cu.gbl, nuc-fan-controller-B_Mask.gbs, nuc-fan-controller-B_Silkscreen.gbo, nuc-fan-controller-Edge_Cuts.gm1, nuc-fan-controller-F_Cu.gtl, nuc-fan-controller-F_Mask.gts, nuc-fan-controller-F_Silkscreen.gto, nuc-fan-controller-Margin.gbr]
2026-10-19 probe-uno: breadboard probe sketch for the BC547 stages
    Driven from an Arduino Uno for now (5 V, 16 MHz) because the Pro Mini is not fitted yet.
    Both waveforms come from hardware timers, so what the scope reads is a property of the timer:
    D9 (OC1A) = 40.000 Hz at the 1200 RPM claim, D11 (OC2A) = 31.25 kHz at 39.8% on the fan side.
    The two Uno-vs-board differences are in the setup, not the result: ICR1+1 = 30 000 000/RPM at
    16 MHz instead of 15 000 000/RPM at 8 MHz, and Timer2 needs prescaler /2 instead of /1 to land
    on the same 31.25 kHz.
    [probe-uno.ino]
2026-10-19 tach: the NUC reads 0.9900 of what the timer emits, measured
    Bench fact from the user's breadboard: the probe sketch's 40.000 Hz tach wave (a 1200 RPM
    claim) shows as 1188 RPM in this NUC's BIOS. 1188/1200 = 0.9900 exactly, so the reported
    number is a fixed 1% under the emitted one.
    Two candidate causes, and a scope separates them: the Uno's 16 MHz ceramic resonator is
    allowed +/-0.5% and boards often sit ~1% low, or the ITE's tach gate runs slightly longer
    than one second. Emitting 40.401 Hz instead makes the BIOS land on ~1200 either way, so the
    BIOS number cannot tell them apart - only measuring the line can. The probe sketch carries
    ITE_READ_GAIN = 0.9900 and now emits 40.401 Hz (ICR1=2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
    [nuc-tach-modeB.ino, probe-uno.ino]
2026-10-19 probe-gain: a sweep to measure the ITE's read gain instead of guessing it
    Second bench reading: the gained sketch emits 1212.0 RPM and the BIOS now shows 1198, against
    the 1199.9 the 0.9900 gain predicts. Both readings are even, and 1199.9 truncated to a 2 RPM
    display step is 1198 - so gain 0.9900 plus a 2 RPM ITE quantum fits 1188 and 1198 exactly.
    The rival reading (gain 0.98845, from 1198/1212) cannot be separated from it at 1200 RPM: the
    two hypotheses are 3 RPM apart there and the ITE's own step is 2. The gain difference is
    proportional, the display step is not, so probe-gain emits an exact ladder of claims up to
    3000 RPM where they are 4.6 RPM apart and dwells 8 s on each - long enoug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
2026-10-19 probe-gain: read the ITE's PWM demand too, and dwell 20 s not 8
    Scope on this NUC's fan header (J2.3): 23 kHz square, 45% duty. That is inside Intel's
    25 kHz +/-10% for a 4-wire fan, and it is what the board's design already assumed. At 23 kHz
    the divider's 4.08 kOhm Thevenant against 1.1 uF gives tau = 4.49 ms against a 43.5 us period,
    so the ripple the ADC sees is 7 mV - 2.2 counts, 0.24% of the duty span - before the sketch's
    16-sample average. The filter is right; had the line really been 1.56 kHz it would have carried
    116 mV (3.6% of the span) and C10 would have had to become 4.7 uF.
    The sweep now prints the divider's own ADC count and the duty it implies, so the ITE's fan
    curve (claim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
2026-10-19 probe-gain: follow the ITE's demand, and print the divider both ways
    With the divider built on the bench, the ITE's requested duty is not steady: adc swings
    201-259 (33-43% at 6.9k/10k, 39-51% at 10k/10k) on a roughly 6 s cycle, and it does not line up
    with the 20 s tach steps. So the ITE's PWM demand is being set by something slow - its own
    temperature sensors - not by the tach claim. That is the design's premise confirmed: follow the
    demand, and keep the tach plausible enough to avoid a fan error.
    The fan therefore stops sitting at a fixed 40% and follows the measured demand, floored at 30%
    so a bad read cannot stop the fan while the machine is warm. The report prints the same adc
    under b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
    [probe-gain.ino]
2026-10-19 probe-loop: test whether the ITE's PWM request answers the tach at all
    The sweep showed the ITE's requested duty swinging 201-259 in divider counts on a roughly 6 s
    cycle that did not line up with the 20 s tach steps - which suggests the demand comes from the
    ITE's temperature sensors, not the tach line. This tests it instead of reading a coincidence.
    The confound is heat: move the fan and the heatsink temperature moves, and the ITE's demand moves
    for a reason that has nothing to do with the tach. So the fan drive is pinned at 90% and only the
    claimed RPM moves, in a ping-pong ladder 800 / 2000 / 4500 / 2000 at 40 s per rung. Ping-pong
    because a one-way ramp cannot be told apart from the ma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
2026-10-19 measured: the ITE's PWM demand does not answer the tach
    5.6 minutes of a 40 s ladder (800 / 2000 / 4500 RPM claims, fan drive pinned at 90% so heat
    stayed out of it), 337 samples at 1/s, duty read through the divider on the bench:
    claim 800 -> mean 233.6 counts claim 2000 -> 234.0 claim 4500 -> 231.0
    A 5.6x swing in claimed RPM moved the ITE's requested duty by 2.5 counts out of 233 (-1.1%),
    while the same claim swung 195-260 on its own with an autocorrelation peak at 6 s. Dwell means
    were flat across the rung boundaries (253 234 233 / 233 232 235 233 / 229 233): no step where
    the claim changed.
    So the demand is generated by the ITE's own policy. The tach's job is to keep the ITE s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
2026-10-19 probe-temp: hold the tach claim still and move the temperature instead
    The ladder showed the ITE's demand ignores the claimed RPM. This tests the other candidate with
    everything else pinned: one exact claim (1500 RPM, 50.000 Hz, ICR1 19999) for the whole run, fan
    drive fixed at 90% so the board is not changing the cooling either. Whatever the divider reads is
    then the ITE reacting to its own sensors - or to nothing.
    Paired with a load profile on the NUC (60 s idle, 200 s loaded, 170 s cooling) so a duty change
    that rises with the load and falls again when the load is removed reads as a response, while a
    change that happens once and stays is drift.
    [probe-temp.ino]
2026-10-19 bench: the ITE's demand tracks package temperature, r = +0.822 at a 4 s lag
    Claim frozen at 1500 RPM (50.000 Hz) for 427 s, fan drive pinned at 90%, while the NUC's package
    was driven 55 -> 83 -> 53 C by a four-core stress-ng load plus bench fans switched in by hand.
    10 s means divider counts package
    idle 229-239 (band 197-259) 55 C
    load, 60-90 s in 244 -> 326 63 -> 81 C
    load plateau 322-328 (band 316-358) 79-82 C
    load still on, fans cooling 282 -> 264 76 -> 71 C
    load removed 236 -> 230 55 -> 53 C
    Best correlation at offset -4 s: the dema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
2026-10-19 bench photos: cropped focal points, captions, and a README section for them
    Nine phone photos of the bench. docs/bench/ carries eight crops at the focal points that matter
    to the design - the four-wire harness in the NUC's fan header, the divider tap on the breadboard,
    the scope on the fabricated tach square wave, the BIOS reading 1186 RPM against a 1200 claim, both
    ends probed at once, the parts drawer the BOM was written against, and the scope with the buck
    module. bench/prepare-photos.py reproduces every crop from the originals, which stay out of the
    repo (images/ is gitignored) because the crops are the readable artefacts.
    Captions carry the measured numbers rather than describing the p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
2026-10-19 the ITE's demand has a floor at ~235 counts, and it is stepped, not analog
    Twelve minutes with the bench fans at maximum pulled the package to 32-36 C - 21 C below the
    plateau the temperature run had been stuck at - and the ITE's requested duty did not follow it
    down: 196-260 counts, median 239, and not one sample of 717 below 100. Combined with the hot run
    the curve is flat from 33 C to about 60 C at ~235 counts and ramps above it: 260 at 70-75 C, 309
    at 75-80, 319 at 80-85. So the fan this board drives never stops, FAN_DUTY_MIN is a clamp against
    a broken sense wire rather than something the ITE ever reaches, and a fan that is always turning is
    a fan whose tach claim is always plausible.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
    [nuc-tach-modeB.ino, probe-divider.ino]
2026-10-19 gitignore: KiCad session locks (~*.lck) and the editor's own *-backups/ directory
2026-10-19 the bench divider is two 10k: the duty scale is 512 counts on the Uno, and the counts become volts
    The builder confirms the breadboard carries 10k over 10k, which the dwell lattice had already
    pointed at. Ratio 0.500, so on the Uno - whose ADC reference is its own 5 V rail - 100% duty is 512
    counts, and every count in bench/data/ reads on that scale. probe-temp, probe-loop and probe-gain now
    print the 512 duty as the primary and keep the 605 reading as the alternate for the schematic's
    4.7k+2.2k/10k. All four sketches compile clean, modeB on arduino:avr:pro:cpu=8MHzatmega328.
    In volts, which is what a meter has to agree with: the ITE's three dwell levels are 198, 257 and 318
    counts = 0.969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
2026-10-19 BUILD.md: how to scope the PWM line so the top and the rising edge stop being ambiguous
    A 1x probe loads the line it is measuring, a long ground lead manufactures overshoot, and the flat top
    can be computed rather than eyeballed: read the scope's Avg while the Uno prints its count, duty is
    adc/512 on the confirmed divider, and top = Avg / duty. At the cold high dwell that predicts 2.51 V for
    a 5.0 V top and 2.76 V for a 5.5 V top - a quarter of a division at 1 V/div. Then single-shot the rising
    edge at 200 ns/div and compare the peak with the stock blower on and off the header: if the top rises
    when the load comes off, the ITE's output is open-drain and the loaded top is the one the divider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
2026-10-19 the ITE's fan demand follows the board's temperature, not the cores - the published claim corrected
    Re-running the stress test with the bench fans at maximum separates two things the first temperature
    run could not. Same sketch, same frozen 1500 RPM claim: stress-ng --cpu 4 for 300 s took the package
    34 -> 73 C and back to 38 C, the PCH only reached 55.5 C, and the ITE's requested duty did not move.
    195-260 counts for eleven minutes, the same band it sits in at 34 C. r against the package: +0.049.
    Against the PCH: +0.065. Nothing moved, at any temperature, in load or in cooling.
    Pooled with the first run and binned by the board, the data is monotone where binning by the cores is
    not: 242 co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
2026-10-19 the fourth run: a board at 68 C takes the ITE to 380 counts, and the dwell ladder says the PWM top is 4.9 V
    - warm.log + warm-temps.log: bench fans off, NUC blower at minimum, board warmed by hand, then
    stress-ng --cpu 4 for 240 s. Board to 68.5 C, package pinned at 88 C, demand 380 counts (74 %,
    3.71 V on the wire) with 434 (85 %) seen, and the release: 381 -> 242 counts within 30 s of the
    board falling back through 55 C.
    - bench/plot-curve.py -> docs/bench/06-ite-fan-response.svg: all 2777 paired samples against board
    temperature with the 196 cores-hot/board-cool samples drawn as open circles, and the warm run in time.
    - the dwell ladder is 198 / 257 / 320 / 380, spacing 60.9 count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
2026-10-19 the ITE does not integrate time at temperature: 16 flat minutes at 68.5 C holds the duty at 378 counts
    - hold.log + hold-temps.log: 300 s four-core ramp, then 1200 s at a two-core load. Board settled at
    68.5-69.0 C and stayed there for sixteen flat minutes with the package at 84-86 C; the demand sat at
    378 counts, the same 6/8 rung the warm run found at the same board temperature, repeatable to 2 counts.
    - three reads, all the same answer (bench/analyze-hold.py): across the 16 flat windows the demand trends
    +0.6 counts/min while the board's own +0.07 C/min drift already explains +1.5; the same temperature
    reached quickly against reached and held is 342 vs 319 counts at 63-66 C and 37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
2026-10-19 the graph now carries the hold run in time too: three panels, five runs, 4577 samples
2026-10-19 nuc-fan-controller: the 19V->12V converter is a module now, not parts on the board
    Seven parts and their copper — U1 LM2596T-ADJ, L1 100 uH 6 A toroid, D1 1N5822,
    C1 220u/35V, C2 100n, R1 1k, RV1 10k trim — are replaced by J6, a 1x04 header
    (1,2 GND / 3 19V / 4 +12V) that a finished XL4016E1 step-down module from
    cabinet L1 A10 plugs into. C3 470u/25V and C4 stay as the board's local
    decoupling where the 12 V rail lands.
    This reverses an earlier instruction: the XL4016E1 module had been ruled out and
    the converter built from parts instead. The ruling is lifted. BUILD.md says so
    out loud and carries the arithmetic that makes the module the better answer at
    12 V / 1 A — 5-40 V in, 1.2-3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
    [nuc-fan-controller-B_Cu.gbl, nuc-fan-controller-B_Mask.gbs, nuc-fan-controller-B_Silkscreen.gbo, nuc-fan-controller-Edge_Cuts.gm1, nuc-fan-controller-F_Cu.gtl, nuc-fan-controller-F_Mask.gts, nuc-fan-controller-F_Silkscreen.gto, nuc-fan-controller-Margin.gbr]
2026-10-19 the fan load is measured now: three 12V fans at full speed draw 300 mA together
    100 mA each, 3.6 W — not the 2 x 0.5 A the design assumed. The 12 V rail, the
    19 V draw, the IRFZ44N dissipation (0.004 W) and the 1.5 mm Power class all get
    re-quoted against the measurement.
    It also brings one new limit that the assumed load hid: the module's ~0.16 A
    inductor ripple puts its continuous-conduction boundary near 0.08 A, and fan
    current scales with speed, so at the ITE's idle demand the rail can slip into
    discontinuous conduction. C3 470uF and FAN_DUTY_MIN are the two things already
    on the board that answer it.
2026-10-19 schematic: name tags and power symbols moved onto the things they belong to
    Hand pass in the KiCad editor. PWM_DIV now sits on the R3-R4 node itself instead
    of on a stub; the +12V symbol sits on U2's VIN pin; the C3/C4 +12V stub is
    shortened; J6's GND and +12V symbols move to either side of the header; TP1 is
    flipped to hang on the tach line. 56 wires and 5 junctions.
    ERC 0 violations. DRC with --schematic-parity: 0 violations, 0 unconnected items,
    and the one documented J2 pin-4 no-connect warning — the board still matches.
    Note for anyone regenerating: logs/genwires.py + applywires.py still describe the
    pre-edit wire set (52 wires), so running them now would replace this routing and
    or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
    [nuc-fan-controller.kicad_sch]
2026-10-19 Wire Q1/Q2 for the BC547s that are actually in the cabinet
    The two transistors in R1 D3 are the NXP/Philips order — 1 emitter, 2 base,
    3 collector. KiCad's Transistor_BJT:BC547 is the onsemi order (1 C, 2 B, 3 E), so
    the schematic, the footprint pad numbers and the parts disagreed. Both symbols are
    now Transistor_BJT:Q_NPN_EBC, which draws at identical pin coordinates and differs
    only in the pin numbers: nothing on the drawing moved, the nets moved.
    schematic (logs/fixq.py)
    Q1/Q2 -> Q_NPN_EBC, Sim.Pins 1=E 2=B 3=C, and the Datasheet link plus the
    Description now state the pinning. ERC 0 violations.
    board (logs/fixboard.py, fixboard2.py, fixboard3.py)
    Pad 1 is the emitter on the GND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
    [nuc-fan-controller-B_Cu.gbl, nuc-fan-controller-B_Mask.gbs, nuc-fan-controller-B_Silkscreen.gbo, nuc-fan-controller-Edge_Cuts.gm1, nuc-fan-controller-F_Cu.gtl, nuc-fan-controller-F_Mask.gts, nuc-fan-controller-F_Silkscreen.gto, nuc-fan-controller-Margin.gbr]
2026-10-19 collection sheet: every BOM line with its cabinet drawer, plus the measurements the footprints wait on
    BUILD.md's BOM table had six wrong drawers (C3/C5/C10 were listed in L1 A1, Q3 in R1 A4,
    D2 in R1 C3, R3 in R1 A2, R9 in R1 A2) and the retired-buck paragraph named four more; all
    re-checked against the inventory.
2026-10-20 Rebuild the board as one copper layer, 88.90 x 76.20 mm, for home etching
    The board is now generated by logs/build1l.py instead of routed by Freerouting: parts,
    drawn rails, holes, silkscreen and a small A* for the short legs all live in that script,
    with footprint artwork cloned out of the KiCad 10 libraries by logs/getfp.py into
    logs/fp-templates.inc. logs/setrules.py writes the home-etch rules into the project.
    Rules: clearance and minimum track 0.70 mm, drawn rails 1.80 mm, copper-to-edge 0.50 mm,
    minimum drill 0.90 mm, maximum pad 1.80 mm, pour minimum thickness 0.80 mm. Every layer
    is F.Cu, and F.Cu is the component side, so the copper that gets etched is the copper the
    parts solder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
    [nuc-fan-controller-B_Cu.gbl, nuc-fan-controller-B_Mask.gbs, nuc-fan-controller-B_Silkscreen.gbo, nuc-fan-controller-Edge_Cuts.gm1, nuc-fan-controller-F_Cu.gtl, nuc-fan-controller-F_Mask.gts, nuc-fan-controller-F_Silkscreen.gto, nuc-fan-controller-Margin.gbr]
2026-10-21 12 V fan switch from 3.3 V logic: gate booster + IRFZ44N, fully simulated
    Built entirely from parts in my own cabinets (L1 and R1):
    Q1 IRFZ44N (R1 B4), Q2 2N7002 (R1 A4), Q3 IRF7416 (R1 A4),
    D1 1N5819 (L1 E1), 1k (R1 A2), 10k (R1 B2), Pro Mini 3V3 (L1 C5),
    12 V 450 mA supply module (L1 B7).
    Schematic: A3 sheet, ERC clean (0 errors / 0 warnings), 16 components,
    2 PWR_FLAGs, 44 wires, 38 net labels, 22 junctions, 15 annotated text
    blocks including the ngspice analysis cards.
    Simulation (sim/run.sh): KiCad SPICE export -> ngspice -> matplotlib
    plots + a six-way comparison of the drive options the bin allows.
    booster : gate 10.91 V, fan 152 mA, Rds 15.9 mOhm, 0.37 mW in Q1
    booster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
    [mosfet-fan-switch.kicad_pcb, mosfet-fan-switch.kicad_sch, v1-irlz44n-5v-low-side.kicad_sch]
2026-10-21 Size the fan model to my real fans (100 mA) and check 1-4 fans on one output
    R6 on the sheet is now 120 ohm, so the fan model (10 mH + 120 ohm) draws the
    100 mA my actual 12 V fans draw instead of 150 mA. Every quoted number in the
    sheet text, the README and the plots follows: fan 102 mA, V(drain) 1.6 mV,
    Rds 15.7 mOhm, 0.16 mW in Q1, spike clamped at 12.36 V, fan L/R 83 us, average
    54 mA at 1 kHz / 50 %.
    New sim/fan_count.py clones the sheet's fan branch 1..4 times (it reads L and R
    from the exported netlist so the sheet stays the source of truth) and checks the
    result against the ratings of the parts that actually carry load current:
    3 fans: 302 mA total, 4.8 mV at the drain, 1.46 mW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
    [mosfet-fan-switch.kicad_sch]
2026-10-21 Fan-count check with the supply I actually use (8 A): the diode is the limit, not the FET
    sim/fan_count.py now takes --fans and --supply-ma instead of being fixed at 1..4 fans
    and the 450 mA bin module, caches its ngspice runs so the plot reuses them, uses coarser
    transient steps once the load is large, and adds a Q1 junction-temperature-rise column
    (TO-220, 62 C/W in free air, no heatsink).
    python3 sim/fan_count.py --fans 1 2 4 8 16 32 64 --supply-ma 8000
    8 fans: 801 mA total, 10 mW in Q1 (+0.6 C), 779 mA peak through D1 -> fits as drawn
    16 fans: 1.60 A total, 41 mW in Q1 (+2.5 C), 1534 mA peak -> needs the 1N5822 (3 A)
    32 fans: 3.19 A total, 164 mW in Q1 (+10 C), 2985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
    [fan_count.py]
2026-10-21 Single-layer PCB for the fan driver: 56 x 44 mm, all copper on B.Cu, DRC clean
    pcb/build_board.py generates the board from a part table, a track list and the
    design rules, embedding the KiCad library footprints it needs. Re-running it is
    a no-op: ids are derived from the content (uuid5) and the 14 electrical footprints
    reuse their symbols' uuids from the sheet, so cross-probing and Update PCB from
    Schematic treat the board as the same 14 parts instead of 18 unknown ones.
    Home-etch rules in the .kicad_pro netclass (clearance 0.50 mm, min track 0.80 mm)
    instead of KiCad's fab defaults. Result:
    Found 0 violations
    Found 0 unconnected items
    56 x 44 mm (the four 3.2 mm M3 holes set the size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
    [mosfet-fan-switch.kicad_pcb, mosfet-fan-switch.kicad_sch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]
2026-10-21 PCB drawings: show the copper side the way you build from it
    The board itself was right; the drawings around it were not.
    - docs/pcb-assembly-bottom.pdf (new): the copper side as you look at it,
    mirrored, with every pad outlined and numbered. Q3's notch sits beside pad 1,
    1-2-3-4 along the near row, 8-7-6-5 along the far row. This is the sheet to
    solder Q2/Q3 from.
    - docs/pcb-assembly-top.pdf: now F.SilkS/F.Fab/Edge.Cuts only. The old plot
    mixed B.Cu and B.SilkS into a top-side view, which is what made the IRF7416
    read as mirror-imaged.
    - docs/pcb-render-smd-copper.png (new): close-up of Q2 and Q3 on the copper side.
    - pcb-etch-bottom.svg: kicad-cli draws the drawing-sheet frame,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
2026-10-21 Attach the library 3D models so the SMD parts are visible on the copper side
    build_board.py now carries each footprint's library (model ...) block into the
    board: SO-8_3.9x4.9mm_P1.27mm, SOT-23, TO-220-3, D_DO-41, the 0207 resistors,
    C3/C4 and the pin headers. docs/pcb-render-smd-copper.png is therefore a real
    SO-8 lying on the copper with its pin-1 dot next to the silkscreen notch and
    pad 1, which is the view you get when you flip the etched board over.
    docs/pcb-notes.md: added the datasheet comparison (turn the SO-8 top-view
    picture 90 deg counter-clockwise and it is this board) and how to see it in
    KiCad: View -> Flip Board View, Ctrl+H cycles display modes. Also a warning
    that the .kica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
    [mosfet-fan-switch.kicad_pcb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]
2026-10-22 schematic + sim: NUC fan-header interface (PWM request divider, tach answer)
    - J2 grown to 1x04 (Pro Mini), J4 added as the NUC's own 4-pin fan socket
    - R7/R8 divider 10k/10k takes the NUC's 5 V PWM request down to the 3.3 V the
    Pro Mini expects; C5 1u + C6 100n filter it (tau 5.49 ms)
    - R9 1k + Q4 (BC547) answer on the tach line as an open collector; the pull-up
    lives in the NUC (V4 + R10, both DNP)
    - sim-only stand-ins V3/V4/V5, all DNP; connectors excluded from simulation
    - fixed a pre-existing wiring bug: the old V2 -> R1 /PWM wire ran down U1's pin
    column and shorted D10-D13 to /PWM. /PWM is D9 only.
    - sim/nuc_link.py: duty table (2.500 V tap, 775 counts at 100 %, <=5 mV ripple),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
    [mosfet-fan-switch.kicad_sch]
2026-10-22 pcb: grow the board to 56 x 68 mm and route the NUC interface band
    The fan driver keeps its exact v1 copper (tag checkpoint-fan-driver-v1); the
    NUC link lives in a new band from y=44 to y=68, below the 12 V bus.
    - board 56.0 x 68.0 mm, 26 footprints, 63 track segments, zero vias
    - band GND is fed from the right: the top /GND rail runs to x=51.5, drops 1.5 mm
    past the round end cap of the 12 V bus, then runs back along y=58 - so nothing
    in the band has to cross the 12 V rail
    - /PWM returns to R1 through the only free corridor, the 0.8 mm lane at x=1.69
    up the left edge; JP1 (R_Axial_DIN0207 P7.62 at (5.5,14) rot 0) bridges the GND
    spine at y=14. Fit it as a 0 ohm axial with the lead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
    [mosfet-fan-switch.kicad_pcb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]
2026-10-22 schematic: package-accurate transistor symbols; board stripped to a routing skeleton
    The four transistors are now symbols whose pin numbers are the real leg numbers, so
    KiCad's "symbol pin N <-> footprint pad N" rule puts every net on the correct leg and
    Update PCB from Schematic agrees with the layout instead of fighting it.
    - mosfet-fan-switch.kicad_sym + sym-lib-table: Q_NMOS_TO220 (1 gate, 2 drain, 3
    source), Q_NMOS_SOT23 (1 gate, 2 source, 3 drain), Q_PMOS_SO8 (1-3 source, 4 gate,
    5-8 drain), Q_NPN_TO92 (1 emitter, 2 base, 3 collector). KiCad ships nothing like
    these: Transistor_BJT:BC547 extends Q_NPN_CBE (wrong for the flat-face TO-92) and
    there is no IRFZ44N symbol in any l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
    [mosfet-fan-switch.kicad_pcb, mosfet-fan-switch.kicad_sch]
2026-10-22 pcb: embed the Arduino Pro Mini on sockets, grow the board to 56 x 92
    - pcb/pro_mini.py: the clone hole map (35 holes) in one editable place, and the
    generator for pcb/footprints/mosfet-fan-switch.pretty/Arduino_Pro_Mini_328_Socket
    - fp-lib-table so KiCad can find that footprint
    - U1 sits on three female headers; pad numbers == hole numbers == symbol pins
    - J5 mirrors the module's programming row for FTDI/CH340, J6 is the 2x3 ICSP
    header with pin 2 (programmer VCC) left dead on purpose
    - D2 (1N5822, DO-27) and D3 (TO-220, MBR10100CT) stand unpopulated across
    /P12V-/DRAIN for the 12+ fan case
    - J2 deleted; JP1 moved so its pads actually straddle the GND spine
    - generated routing extende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
    [mosfet-fan-switch.kicad_pcb]
2026-10-22 sch: draw the Pro Mini itself, with its FTDI and ICSP headers
    The Nano stand-in is gone. U1 is now mosfet-fan-switch:Arduino_Pro_Mini_328,
    generated from the same hole map as the board's socket footprint, so a symbol
    pin number, a footprint pad number and the hole's silkscreen name are one
    number. J2 - the header that used to carry four signals to a module that was
    not on the board - is deleted.
    * pcb/pro_mini.py now emits the symbol as well as the footprint.
    * tools/embed_pro_mini_schematic.py is the one-shot migration: it drops the
    Nano and J2 with their labels, no-connects and stubs, draws U1, J5 (FTDI
    row), J6 (2x3 ICSP, pin 2 deliberately dead), D2 and D3 (spare flyback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
    [mosfet-fan-switch.kicad_pcb, mosfet-fan-switch.kicad_sch]
2026-10-22 docs: rewrite the board notes and README around the embedded module
    docs/pcb-notes.md is the build sheet, so it now carries what the board actually
    is: 56 x 92 mm, 30 footprints, the module deck, the full 35-hole U1 pad -> net
    table, J5 and J6, the two spare diode footprints, and the 102-hole drill set
    (0.8 x29, 1.0 x59, 1.1 x8, 1.2 x2, 3.2 x4 - verified against the Excellon file).
    * The corridor plan is spelled out net by net, because the two full-width
    rails are walls and the left edge holds four lanes in six mm.
    * "/P12V -> U1 pad 13" is named as the one connection the generator will not
    draw, with three honest ways to finish it and the recommendation (re-home
    the module'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
    [mosfet-fan-switch.kicad_sch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]
2026-10-23 pcb: state the fab rules in the generator, pour /GND and /P12V, park a maze router
    build_board.py now declares the prototype limits it is designed against - 0.30 mm clearance and signal track, 1.5 mm power, 0.40/0.80 mm via - and gives /P12V, /GND and /DRAIN their own net classes. Pad numbers are the real package pin numbers rather than the schematic symbol's SPICE order. The regenerated board gains two zone definitions (/GND on B.Cu, /P12V on F.Cu) and is still a placement skeleton with no tracks. router.py is a 0.254 mm grid A* router with 5.08 mm 0 ohm jumper hops, for the single-layer variant. Courtyard DRC severities are relaxed because the Pro Mini socket courtyards necessarily overlap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
    [mosfet-fan-switch.kicad_pcb]
2026-10-23 archive: park the single-layer build and the other attempt out of the working tree
    Kept for reference. The board that gets worked on is the one at the repository root.
    [mosfet-fan-switch-1layer.kicad_pcb, mosfet-fan-switch.kicad_pcb]
2026-10-23 firmware: the bench sketches - ladder, serial, carrier in hertz, debug
    0 % is made by clearing COM1A1:0 and holding D9 low as GPIO, because OCR1A = 0 in fast PWM is not off: it is a 125 ns spike every carrier cycle, and the booster turns that into about 10.9 V on Q1 gate for tens of microseconds. That spike is what the fan was humming at 0 percent. fan-switch-freq makes the carrier a command as well as the duty, so the same duty can be compared at 100 Hz and at 25 kHz without reflashing, and both ladder and freq now default to a 100 Hz carrier with a prescaler of 8 - the value the scope measured quiet.
2026-10-23 firmware: bench scripts to flash and command the Pro Mini
    flash-bootloader.sh compiles and writes through the module's own bootloader at 57600, with DTR supplying the reset pulse. set.sh leaves the sketch in a commanded state so the board can be probed with the port released, and waits 3 s and sends twice because ATmegaBOOT eats anything sent in the first second after that reset. seq.sh drives a timed sequence so a duty range can be listened to. verify-flash.sh reads all 32 kB back over ISP and compares app and boot section against the compiled hex.
2026-10-23 sim: print the measured perfboard numbers beside the model's optimistic ones
    The netlist models /BOOT with 1.7 nF, which is only the IRF7416 Ciss; the hand-built board carries about 8 nF and its turn-off measures ~170 us rather than the ~55 us the model predicts. The summary now shows both, so the model number cannot be read as a board measurement.
2026-10-23 docs: what the scope measured, and why the carrier is 100 Hz
    CH1 on /GATE and CH2 on /DRAIN agree with each other: a commanded 500 us of conduction becomes 652 us on the gate and 680 us on the drain at 1 kHz. The error is therefore a fixed ~170 us, which predicts the ~2 V offset a multimeter sweep had already produced, and explains why 25 kHz is stuck on - the off half-period there is 20 us. Calibrating C2 against 652 us puts the perfboard node near 8 nF. At 100 Hz the delivered duty is 48.1 percent for 50 percent commanded, and the whole 0 to 100 percent sweep ran with no humming at any rung.
2026-10-23 docs: AGENTS.md - what not to rediscover about this board
2026-10-23 docs: retire the designed PCB - the circuit is built on perfboard instead
    The perfboard build is the circuit: it runs and it is quiet, so the KiCad board is a design record rather than work in progress. The board chapter keeps its layout reasoning and its routing defects, but is marked retired and not waiting to be routed or fabbed. AGENTS.md now says so directly, which also drops the open item about one copper layer versus the generator's two pours - moot once no board is being made.
2026-10-23 docs: correct the claim that Timer 1 drives the fan and the tach at two frequencies
    OC1A and OC1B are compare channels of one 16-bit counter, so in fast PWM they share ICR1 and therefore the frequency - only the duty can differ. The claim was wrong, and fan-switch-debug already knew: it toggles OC1B in software every fifth overflow to get 100 Hz out of a 1 kHz counter. It matters for the NUC link because a fan carrier above 350 Hz drags the tach carrier out of the legal 23-350 Hz window with it.
2026-10-23 docs: correct the NUC header assumptions against the measured 6th-gen i3
    The sibling project ../nuc-tach-sim measured this NUC's fan control directly - 4577 paired samples. The header's own fan supply is 5 V on that machine, not 12 V, and the ITE's request tops out near 4.90 V. The demand has a 46-48 percent floor, so under ITE control the fan never stops, and it follows the board temperature rather than the cores. Intel publishes no pinout for these headers, so the pin numbering this README used is now marked as this project's own convention rather than a fact. Also records the ADC scale trap: those logs are on an Uno's 5 V reference where 512 counts is full duty, while the same 2.50 V tap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
2026-10-23 sch: re-saved by KiCad 10 - schema 20260101 to 20260306, sheet given a real UUID and title
    Not an edit: 56 symbols before and after, same wire set. eeschema rewrote the file and filled in the sheet UUID and sch_revision that the scripted edits had left empty. Committed so the merge carries the state KiCad last wrote.
    [mosfet-fan-switch.kicad_sch]
2026-10-23 KiCad 10 re-saves: the live project settings and the archived modeA sheet
    No design change - eeschema dropped the micro_via_diameter keys it no longer writes and rewrote the archived sheet in the current schema. Committing so the merge below lands on a clean tree.
    [nuc-tach-sim.kicad_sch]
2026-10-23 restructure: park the whole fan-switch design under fan-switch-booster/
    Self-contained subtree: its own .gitignore, KiCad project, sim pipeline, board generator, firmware and docs. sim/run.sh resolves paths from its own directory, so it still works unchanged from inside the subtree. This is the shape the merge into ../nuc-tach-sim takes - one repo, two clearly labelled halves, no file collisions.
    [mosfet-fan-switch-1layer.kicad_pcb, mosfet-fan-switch.kicad_pcb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]
2026-10-23 docs: one record for both halves, and the four ways they disagree
    The root README now states which half is the reference - the perfboard for anything about a chopped 12 V fan, the breadboard runs for anything about the ITE - lists the measured facts both halves rest on with their evidence type, and writes down the disagreements instead of smoothing them: drive pin D9 against D11, tach D10 against D9, non-inverting against Q2's inversion, 100 Hz against 31.25 kHz, and 775 counts against 512 counts at the same 2.50 V tap. Records why both carriers are correct for their own gate stage, and the one thing the CAD has not caught up with: the schematic still divides with 4.7k plus 2.2k over 10k for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
2026-10-23 cleanup: one KiCad project left, and the record rewritten to match
    Retired the nuc-fan-controller design from the working tree. The perfboard in
    fan-switch-booster/ is the reference, and every ITE number in this repo was measured
    on a breadboard with an Uno, so nothing measured went with the board. Removed: the root
    KiCad project, exports/, the logs/ board generator, archive/modeA-2026-10-19/, two
    abandoned routings of the booster, and every cache - .mcp-backups (41 board snapshots,
    13 MB), .history, 61 MB of freerouting work, KiCad scratch copies, __pycache__,
    .DS_Store, .kicad_prl, and the uncropped phone originals. 91 files, 64 MB off the tree.
    Everything removed is complete at the tag n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
    [mosfet-fan-switch-1layer.kicad_pcb, mosfet-fan-switch.kicad_pcb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]
2026-10-23 docs: stale-reference sweep, a repo map, and one duplicate table removed
    Checked every path-shaped reference in the five markdown files against the tree. What
    was stale, and what was done:
    - BUILD.md read as current instructions for a board that is no longer in the tree. Its
    ERC/DRC paragraph, its "Board" chapter, its circuit blocks, BOM and power budget are
    now labelled as the retired board's record, and the generator loop in it (build1l,
    pourcheck, verify, getfp, setrules) says plainly that those files are at the tag and
    must be run from a worktree of it. The live half of the file - meter the four header
    wires, the divider and top-of-swing procedure, the BC547 pin-order check, t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
2026-10-23 docs: the parts sheet now leads with the build that exists
    docs/parts-collection.md and its .html twin were a walk-the-cabinet sheet for the retired
    enclosure board only, which made the one document about parts say nothing about the one
    circuit that is actually built. Both now lead with a new section 1: the perfboard build as it
    actually is - U1, Q1 IRFZ44N, Q2 2N7002, Q3 IRF7416, D1, R1-R5, each with its drawer and what
    it does on the bench, then what the schematic carries that this bench does not (Q4 and the tach
    pull-up, R7/R8 and C5/C6 with A0 unused, the dnp diodes D2/D3, C1/C2 which are Ciss drawn
    explicitly rather than parts, the 450 mA module - the bench runs from an 8 A brick), and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
2026-10-23 docs: state D1's undershoot the way the scope trace recorded it
    The parts sheet said "its freewheel collapsing pulls /DRAIN to -1.2 V". The record is more
    specific, and the specific version is the useful one: the freewheel current D1 carries has to
    collapse through the fan's own ~10 mH, and it does that by pulling the drain below ground -
    which briefly forward-biases Q1's body diode. Measured in the 1 kHz trace.
    Also verified the new section 1 against the schematic rather than against memory: R1 1k, R2 10k,
    R3 10k, R4 1k, R5 10k, R7 10k, R8 10k, C1 1.5n, C2 1.7n, C3 100n, C4 10u, C5 1u, C6 100n,
    L1 10m, R6 120, Q1 irfz44n, Q2 2n7002, Q3 irf7416, Q4 BC547, D1 1n5819 - every value the perfboa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
2026-10-23 pcb done
    [mosfet-fan-switch.kicad_pcb, mosfet-fan-switch.kicad_sch]
2026-10-23 pcb manually designed
    [mosfet-fan-switch.kicad_pcb, mosfet-fan-switch.kicad_sch]
2026-10-24 sch: drop J6, land U1 pad 14 on GND, add four M3 mounting holes
    [mosfet-fan-switch.kicad_sch]
2026-10-24 pcb: edge cuts outline, four M3 holes, GND pour on F.Cu
    [mosfet-fan-switch.kicad_pcb]
2026-10-24 pcb: compact outline to 63.2 x 54.4 mm, four M3 holes at the corners
    [mosfet-fan-switch.kicad_pcb]
